Cosmo1233/CosFly/hardware/flight_controller_v1/Project Outputs for flight_controller_V1/BOM/flight_controller_BOM.xlsx

Description | Designator | Value | Footprint | Quantity | Manufacturer | Manufacturer Part # | Supplier 1 | Supplier Part #
RF ANTENNA Chip Solder Surface Mount ,2.4GHz ~ 2.5GHz ,2 W | ANT1 | 2450AT18B0100001E | ANTC3216X140N | 1 | JOHANSON TECHNOLOGY | 2450AT18B0100001E | Mouser | 609-2450AT18B0100001
Multilayer Ceramic Capacitors MLCC - SMD/SMT Hi-Q 0402 1.2pF 0.1 | C1 | 1.2pF | 0402 (1005 metric) CAP IPC-7351 Level B SMD | 1 | JOHANSON TECHNOLOGY | QSCF500Q1R2B1GV001T | Mouser | 609-QSCF500Q1R2B1GV0
Multilayer Ceramic Capacitors MLCC - SMD/SMT Hi-Q 0402 2.4pF 0.1 | C2 | 2.4pF | 0402 (1005 metric) CAP IPC-7351 Level B SMD | 1 | JOHANSON TECHNOLOGY | QSCF500Q2R4B1GV001T | Mouser | 609-QSCF500Q2R4B1GV0
Multilayer Ceramic Capacitors MLCC - SMD/SMT Hi-Q 0402 2.7pF 0.1 | C3 | 2.7pF | 0402 (1005 metric) CAP IPC-7351 Level B SMD | 1 | JOHANSON TECHNOLOGY | QSCF500Q2R7B1GV001T | Mouser | 609-QSCF500Q2R7B1GV0
Multilayer Ceramic Capacitors MLCC - SMD/SMT 0.1 uF 16 VDC 10% 0402 X7R AEC-Q200 | C4, C10, C11, C12, C13, C17, C18, C19, C21, C22, C23, C24, C25, C26, C27, C28, C30 | 100nF | 0402 (1005 metric) CAP IPC-7351 Level B SMD | 17 | Murata Electronics | GCM155R71C104KA55D | Mouser | 81-GCM155R71C104KA5D
Multilayer Ceramic Capacitors MLCC - SMD/SMT 1 uF 16 VDC 10% 0402 X5R | C5, C9, C14, C16, C20 | 1uF | 0402 (1005 metric) CAP IPC-7351 Level B SMD | 5 | Murata Electronics | GRM155R61C105KA12J | Mouser | 81-GRM155R61C105KA2J
Multilayer Ceramic Capacitors MLCC - SMD/SMT 50V 12pF C0G 0402 0. 25pF | C6, C7 | 12pF | 0402 (1005 metric) CAP IPC-7351 Level B SMD | 2 | KYOCERA AVX | 04025U120CAT2A | Mouser | 581-04025U120CAT2A
Multilayer Ceramic Capacitors MLCC - SMD/SMT 10 uF 10 VDC 20% 0402 X5R | C8, C31, C32 | 10uF | 0402 (1005 metric) CAP IPC-7351 Level B SMD | 3 | Murata Electronics | GRM155R61A106ME11J | Mouser | 81-GRM155R61A106ME1J
Multilayer Ceramic Capacitors MLCC - SMD/SMT 1000 pF 50 VDC 10% 0402 X7R | C15 | 1nF | 0402 (1005 metric) CAP IPC-7351 Level B SMD | 1 | Murata Electronics | GRM155R71H102KA01D | Mouser | 81-GRM36X102K50
Multilayer Ceramic Capacitors MLCC - SMD/SMT 0402 10VDC X5R 4.7uF Tol 10% AEC-Q200 | C29 | 4.7uF | 0402 (1005 metric) CAP IPC-7351 Level B SMD | 1 | TAIYO YUDEN | MSASL105BB5475KFNA01 | Mouser | 963-MSASL105BB5475KF
Multilayer Ceramic Capacitors MLCC - SMD/SMT 4.7UF 10V 10% 0603 | C33 | 4.7uF | 0603 (1608 metric) CAP IPC-7351 Level B SMD | 1 | TAIYO YUDEN | MSASL168SB5475KTNA01 | Mouser | 963-MSASL168SB5475KT
Multilayer Ceramic Capacitors MLCC - SMD/SMT 22 uF 10 VDC 20% 0603 X5R | C34 | 22uF | 0603 (1608 metric) CAP IPC-7351 Level B SMD | 1 | Murata Electronics | GRM188R61A226ME15D | Mouser | 81-GRM188R61A226ME5D
TVS Diode Array Uni-Directional USBLC6-2SC6 17V, SOT-23 6-Pin | D1 | USBLC6-2SC6 | USBLC6-2 SOT-666 | 1 | STMicroelectronics | USBLC6-2SC6 | Mouser | 511-USBLC6-2SC6
LED | D2, D9 | LTST-S326KGJRKT | LTST-S326KGJRKT | 2 | Lite-On | LTST-S326KGJRKT | Mouser | 859-LTST-S326KGJRKT
Standard LEDs - SMD Blue LED | D3, D10 | IN-S85CS5B | INS85CS5B | 2 | Inolux | IN-S85CS5B | Mouser | 743-IN-S85CS5B
Bottom ViewEM/CM/EMS Only | D4 | PESDNC2FD3V3BS | PESDNC2FD3V3BS | 1 | Prisemi | PESDNC2FD3V3BS | LCSC Electronics | C496536
Shottky Diode 20V 1A Surface Mount SOD-323 | D5, D6, D7, D8 | 1N5817WS | SOD2613X110N | 4 | Guangdong Hottech | 1N5817WS | LCSC Electronics | C5190152
USB-C (USB TYPE-C) Receptacle Connector 16 Position Surface Mount | J1 | TYPE-C-31-M-12 | USB-C-31-M-12 | 1 | HRO Electronics | TYPE-C-31-M-12 | LCSC Electronics | C165948
1.25mm Pitch, PicoBlade PCB Header, Single Row, Right-Angle, Surface Mount, Tin (Sn) Plating, Friction Lock, 2 Circuits, Natural, Tape and Reel | J5, J6, J7, J8 | 53048-0210 | 53048-0210 | 4 | Molex Connector Corporation | 53048-0210 | Mouser | 538-53048-0210
RF Inductors - SMD RF MLI 0402 3.3nH 0.3 | L1 | 3.3nH | 0402 (1005 metric) IND IPC-7351 Level B SMD_ | 1 | JOHANSON TECHNOLOGY | LRC0402CS3N3GV001T | Mouser | 609-LRC0402CS3N3GV00
RF Inductors - SMD RF MLI 0402 2.4nH 0.3 | L2 | 2.4nH | 0402 (1005 metric) IND IPC-7351 Level B SMD_ | 1 | JOHANSON TECHNOLOGY | LRC0402CS2N4GV001T | Mouser | 609-LRC0402CS2N4GV00
RF Inductors - SMD RF MLI 0402 2.7nH 0.3 | L3 | 2.7nH | 0402 (1005 metric) IND IPC-7351 Level B SMD_ | 1 | JOHANSON TECHNOLOGY | LRC0402CS2N7GV001T | Mouser | 609-LRC0402CS2N7GV00
RF Inductors - SMD IND 0402 2.0nH S-HQ SMD RF IND | L4 | 2nH | 0402 (1005 metric) IND IPC-7351 Level B SMD_ | 1 | TDK | MHQ1005P2N0CT000 | Mouser | 810-MHQ1005P2N0CT000
SI2302DDS-T1-GE3 N-Channel MOSFET, 2.6 A, 20 V, 3-Pin SOT-363 Vishay | Q1, Q2, Q3, Q4 | SI2302DDS-T1-GE3 | SOT95P237X112-3N | 4 | Vishay | SI2302DDS-T1-GE3 | Mouser | 78-SI2302DDS-T1-GE3
Thick Film Resistors - SMD 2.2K OHM 5% | R1, R2 | 2.2kΩ | 0402 (1005 metric) RES IPC-7351 Level B SMD | 2 | Bourns | CR0402-JW-222GLF | Mouser | 652-CR0402JW-222GLF
Thick Film Resistors - SMD 4.7K OHM 5% | R7, R8, R27, R28, R29 | 4.7kΩ | 0402 (1005 metric) RES IPC-7351 Level B SMD | 5 | Bourns | CR0402-JW-472GLF | Mouser | 652-CR0402-JW-472GLF
Thick Film Resistors - SMD 10K OHM 1% | R3, R14, R16, R17, R23, R24, R25, R26, R32, R34, R40 | 10kΩ | 0402 (1005 metric) RES IPC-7351 Level B SMD | 11 | Bourns | CR0402AFX-1002GAS | Mouser | 652-CR0402AFX1002GAS
Thick Film Resistors 5.1K OHM 1% | R4, R5 | 5.1kΩ | 0402 (1005 metric) RES IPC-7351 Level B SMD | 2 | Bourns | CR0402-FX-5101GLF | Mouser | 652-CR0402FX-5101GLF
Thick Film Resistors - SMD 22 Ohms 1/16 W 50 V 1% 0402 100 PPM / C - 55 C + 155 C AEC-Q200 | R6 | 22Ω | 0402 (1005 metric) RES IPC-7351 Level B SMD | 1 | Yageo | AC0402FR-0722RL | Mouser | 603-AC0402FR-0722RL
Thin Film Resistors - SMD 1/16W 620 ohm .1% 25ppm | R9, R37 | 620Ω | 0402 (1005 metric) RES IPC-7351 Level B SMD | 2 | Yageo | RT0402BRD07620RL | Mouser | 603-RT0402BRD07620RL
Thick Film Resistors - SMD 270 Ohms 1/16 W 50 V 1% 0402 100 PPM / C - 55 C + 155 C AEC-Q200 | R10, R11, R38, R39 | 270Ω | 0402 (1005 metric) RES IPC-7351 Level B SMD | 4 | Yageo | AC0402FR-07270RL | Mouser | 603-AC0402FR-07270RL
Thin Film Resistors - SMD 100K Ohm 0.1% 1/16W 50 Volts 50ppm | R12, R18, R30, R36 | 100kΩ | 0402 (1005 metric) RES IPC-7351 Level B SMD | 4 | Yageo | RT0402BRE07100KL | Mouser | 603-RT0402BRE07100KL
Thick Film Resistors - SMD 510 OHM 1% | R13 | 510Ω | 0402 (1005 metric) RES IPC-7351 Level B SMD | 1 | Bourns | CR0402-FX-5100GLF | Mouser | 652-CR0402FX-5100GLF
Thick Film Resistors - SMD 200K OHM 1% | R15 | 200kΩ | 0402 (1005 metric) RES IPC-7351 Level B SMD | 1 | Bourns | CR0402-FX-2003GLF | Mouser | 652-CR0402FX-2003GLF
Thick Film Resistors - SMD 47 Ohms 1/8 W 100 V 5 % 0402 100 PPM / C - 55 C / + 155 C AEC-Q200 | R19, R20, R21, R22 | 47Ω | 0402 (1005 metric) RES IPC-7351 Level B SMD | 4 | Yageo | AC0402JR-7W47RL | Mouser | 603-AC0402JR-7W47RL
Thin Film Resistors - SMD 1K ohm 1% 1/16W | R31, R33 | 1kΩ | 0402 (1005 metric) RES IPC-7351 Level B SMD | 2 | Yageo | RT0402FRE071KL | Mouser | 603-RT0402FRE071KL
Thin Film Resistors - SMD 1/16W 22.1K ohm 1% 50ppm | R35 | 22.1kΩ | 0402 (1005 metric) RES IPC-7351 Level B SMD | 1 | Yageo | RT0402FRE0722K1L | Mouser | 603-RT0402FRE0722K1L
Tactile Switches Top Actuated w/o boss w/o ground | S1, S2 | B3U-1000P | B3U-1000P | 2 | OMRON Electronics | B3U-1000P | Mouser | 653-B3U-1000P
Toggle Switches 5*2.75mm RoHS | S3 | K3-1292M | K3-1292M | 1 | Korean Hroparts Elec | K3-1292M
Single-Pole, Double-Throw Analog Switch | S4 | SN74LVC1G3157DRLR | SOTFL50P160X60-6N | 1 | Texas Instruments | SN74LVC1G3157DRLR | Mouser | 595-SN74LVC1G3157DRL
Espressif Systems [ENGINEERING SAMPLES]SMD IC , Dual-Core MCU, Wi-Fi 2.4G & BLE 5.0 combo, 8 MB Octal SPI PSRAM | U1 | ESP32-S3FN8 | ESP32-S3FN8 | 1 | Espressif Systems | ESP32-S3FN8 | Mouser | 356-ESP32-S3FN8
Power Switch ICs - Power Distribution 1A Slew Rate Ctrl Load Switch | U2 | SIP32431DNP3-T1GE4 | SON50P160X120X60-5N-D | 1 | Vishay | SIP32431DNP3-T1GE4 | Mouser | 781-SIP32431DNP3-GE4
Remote 8-Bit I2C and Low-Power I/O Expander With Interrupt Output and Configuration Registers | U3 | PCA9534ARGTR | QFN50P300X300X100-17N-D | 1 | Texas Instruments | PCA9534ARGTR | Mouser | 595-PCA9534ARGTR
EEPROM 64K 8KX8 1.8V SER EE IND 1/4AWP RPO | U4 | 24AA64FT-I_MNY | SON50P300X200X80-9N-D | 1 | Microchip | 24AA64FT-I/MNY | Mouser | 579-24AA64FT-I/MNY
IMUs - Inertial Measurement Units Smart Ultra-Low Power Inertial Measurement Unit (IMU) for Wearable Applications | U5 | BMI270 | BMI270 | 1 | BOSCH | BMI270 | LCSC Electronics | C2836813
Board Mount Hall Effect / Magnetic Sensors 3-Axis 1.56x1.56mm WLCSP-12 Geomagnetic | U6 | BMM150 | BMM150 | 1 | BOSCH | BMM150 | LCSC Electronics | C171681
IC; SNSR; DIGITAL; BAROMETRIC PRESSURE SENSOR; LGA8 | U7 | BMP280 | BMP280 | 1 | Bosch Sensortec | BMP280 | LCSC Electronics | C83291
Automotive 4.35V to 16V, 1.5A Li-Ion Charger with Power-Path Management for 5.5V Systems | U8 | BQ24075QRGTRQ1 | QFN50P300X300X100-17N-D | 1 | Texas Instruments | BQ24075QRGTRQ1 | Mouser | 595-BQ24075QRGTRQ1
DC/DC Converters - SMD 1A 5Vin inductor-integrated DC-DC converter | U9 | MUN3CAD01-SC | MUN3CAD01SC | 1 | Cyntec | MUN3CAD01-SC | Mouser | 108-MUN3CAD01-SC
40 MHz +/-10ppm Crystal 10pF 40 Ohms 4-SMD, No Lead , -20C ~ 70C | X1 | 40MHz | ECS4001037B2CKMTR | 1 | ECS | ECS-400-10-37B2-CKM-TR | Mouser | 520-400-10-37B2CKMTR
