Cosmo1233/CosFly/hardware/flight_controller_v1/flight_controller.step

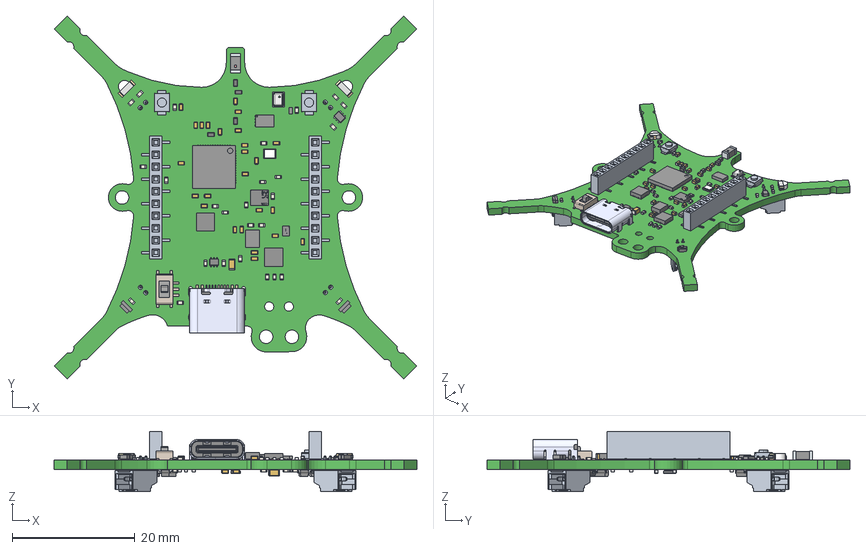
[picture p1: CAD file, 2026-10-15]
hardware/flight_controller_v1/flight_controller.step
59.2 x 59.2 x 9.86 mm
Extruded x 120
BMM150
BODY-SOT
PIN1-ID x 3
Pins x 4
HRO_K3-1293S - K3-1292M
BODY-QFN x 2
B3U-1000P x 2
ThermalPin x 2
PinsArrayLR x 2
PinsArrayTB
TYPE-C-31-M-12
ECS-400-10-37B2-CKM-TR
BMI270
pins
part number
PinsArrayL x 4
FilletPinR x 8
FilletPinL x 4
term1
term2
