Cosmo1233/CosFly/Documents/Schematics/flight_controller_main.pdf

## Breakout & Battery Connectors USB-C Power / Data Connector

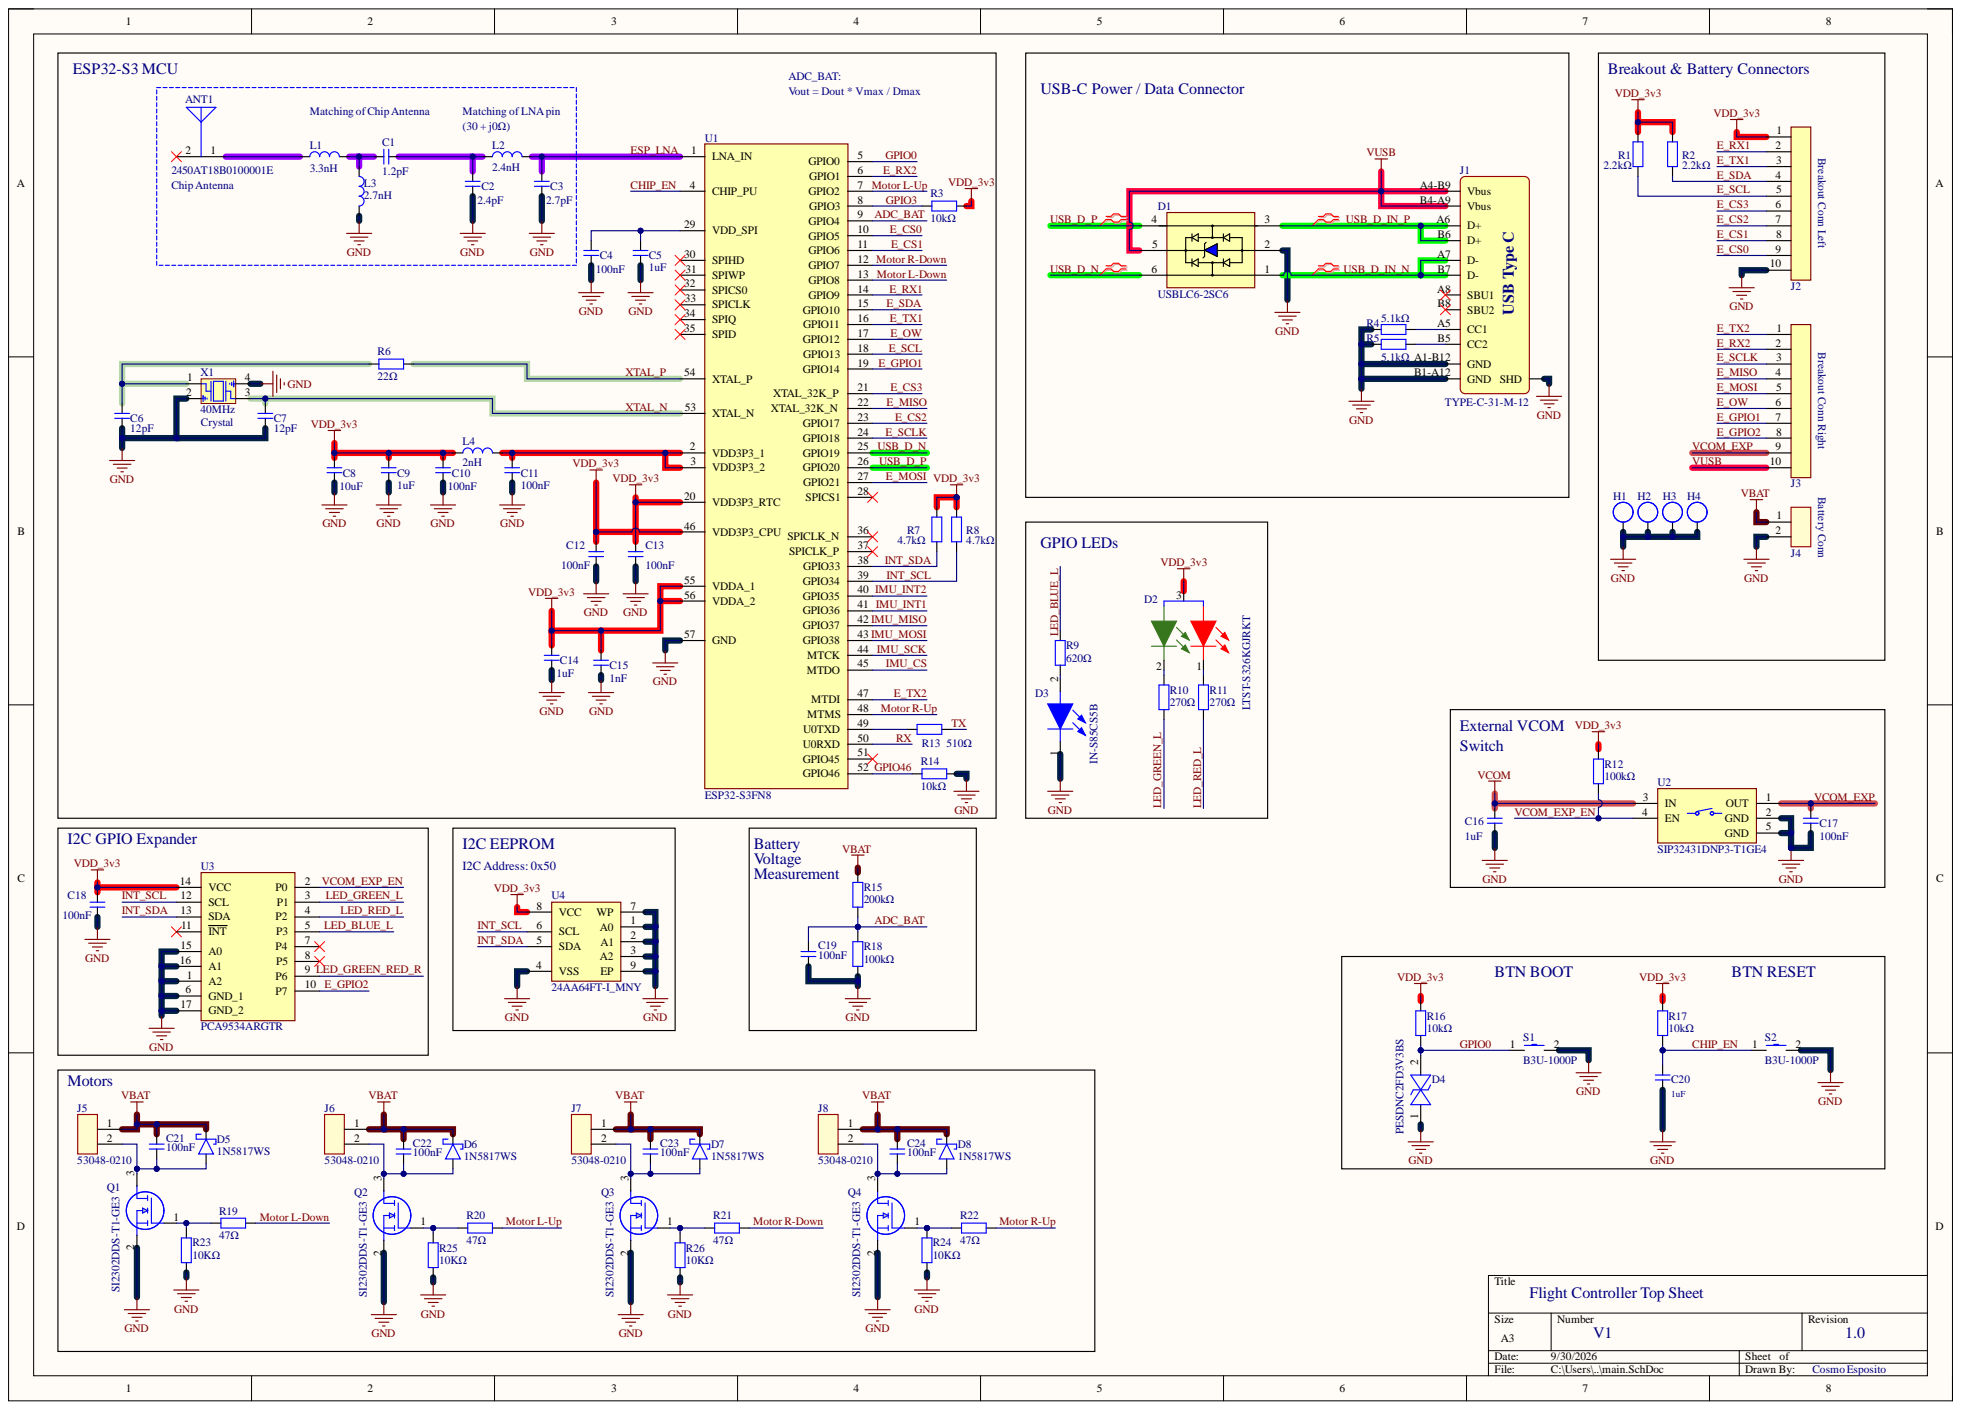
[picture p2: page 1]

ADC_BAT:
Vout = Dout * Vmax / Dmax

Breakout Conn Left Breakout Conn Right

Title
Flight Controller Top Sheet
