Cosmo1233/CosFly/Documents/Schematics/flight_controller_pm.pdf

## PMIC

## & 3.3V Buck Converter

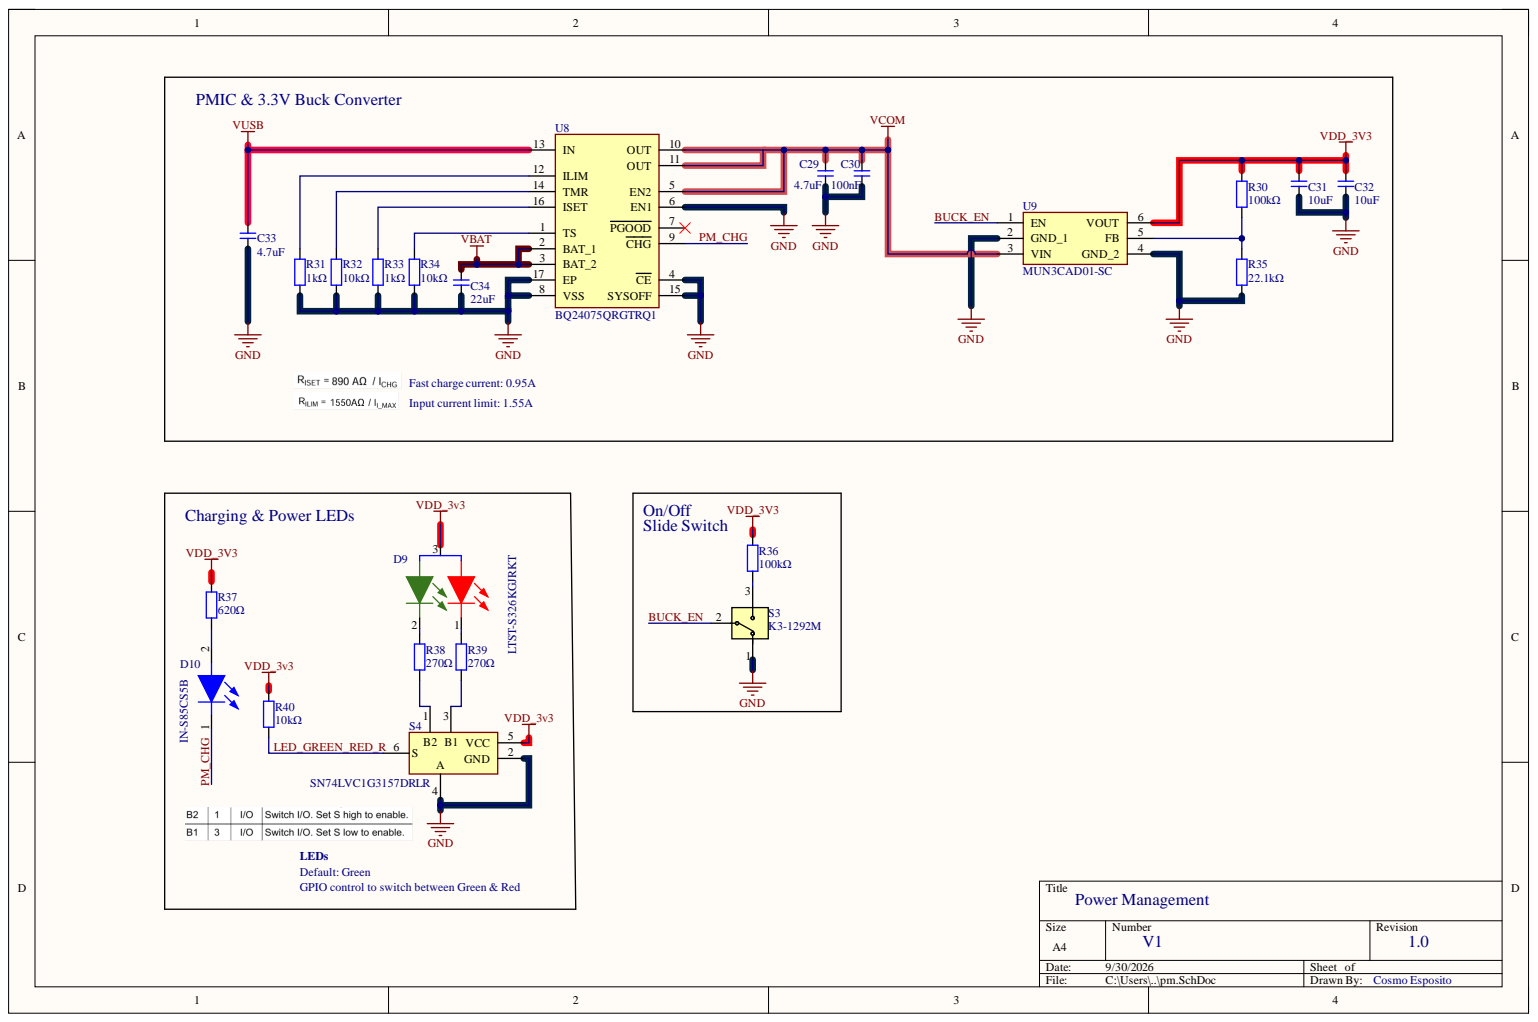
[picture p3: page 1]
Size; umb; Rev; Dat; Sheet; sers; pm.Sch; Draw; Power Management V1; smo; BAT_; VSS; ILIM; ISE; SYSOFF; TMR; QRG; VBAT; VCO; BUCK; CHG 1 2; LTST-S326KGJRKT; VCC; LVC1; RLR; Charging; & Power LED; ide Sw; tch; t curren; imi; Fas; t charge curren; GRE; Defau; Green; GPIO co; tro; bet; ween; Green & Red; LED
