Cosmo1233/CosFly/Documents/Schematics/flight_controller_sensors.pdf

IMU | Magnetometer

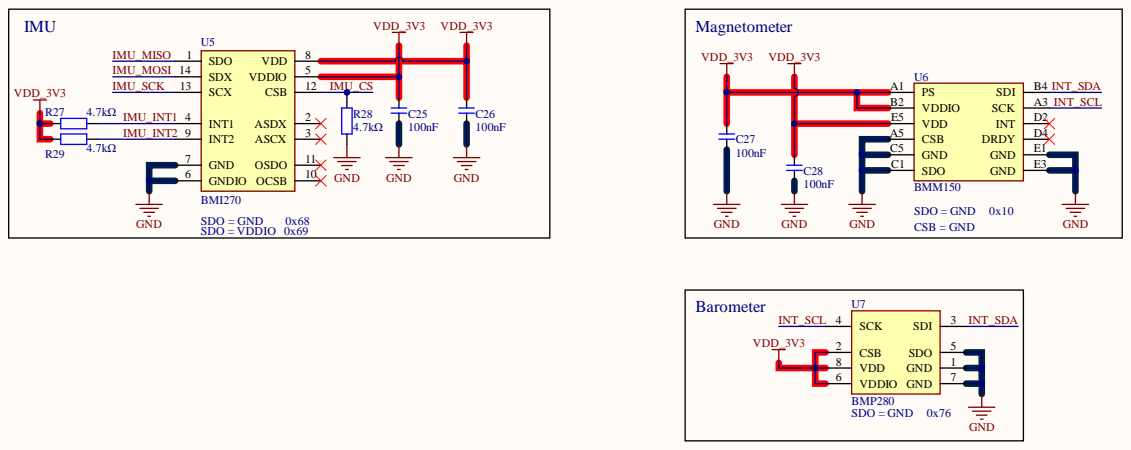
[picture p4: page 1]
