Cosmo1233/CosFly/hardware/flight_controller_v1/Sch PDFs/flight_controller_V1.pdf

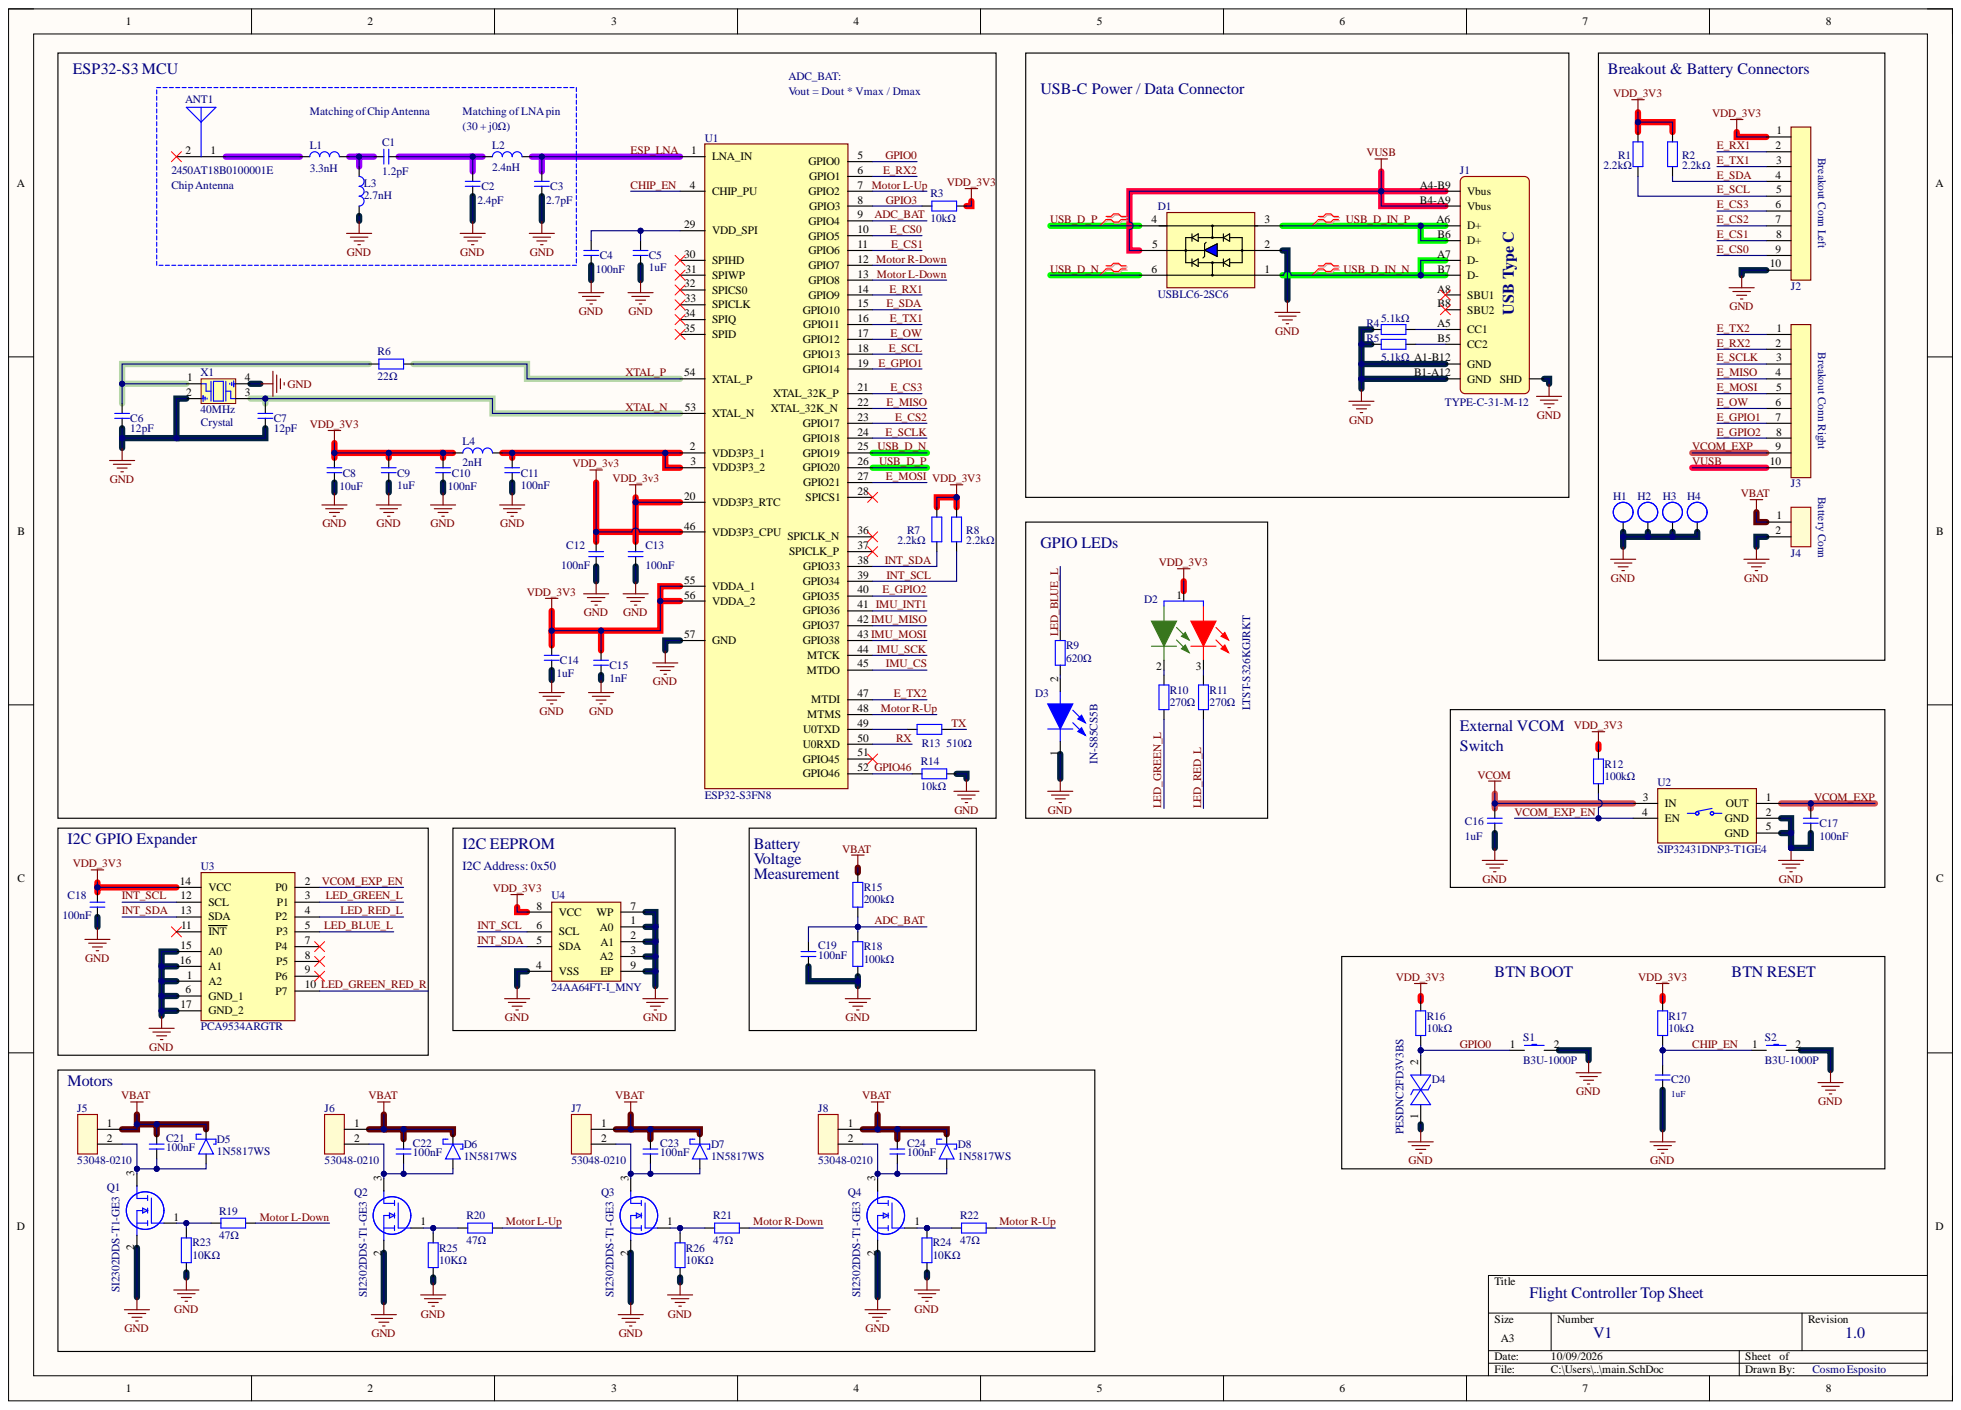
[picture p5: page 1]

ADC_BAT:
Vout = Dout * Vmax / Dmax

USB-C Power / Data Connector

Breakout Conn Left Breakout Conn Right

Title
Flight Controller Top Sheet

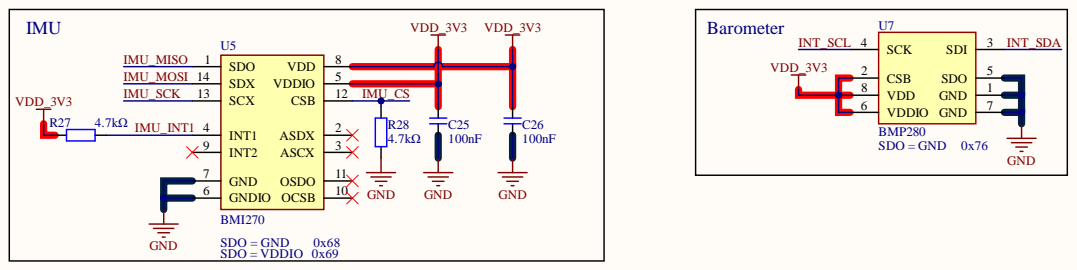
[picture p6: page 2]

IMU _ C S

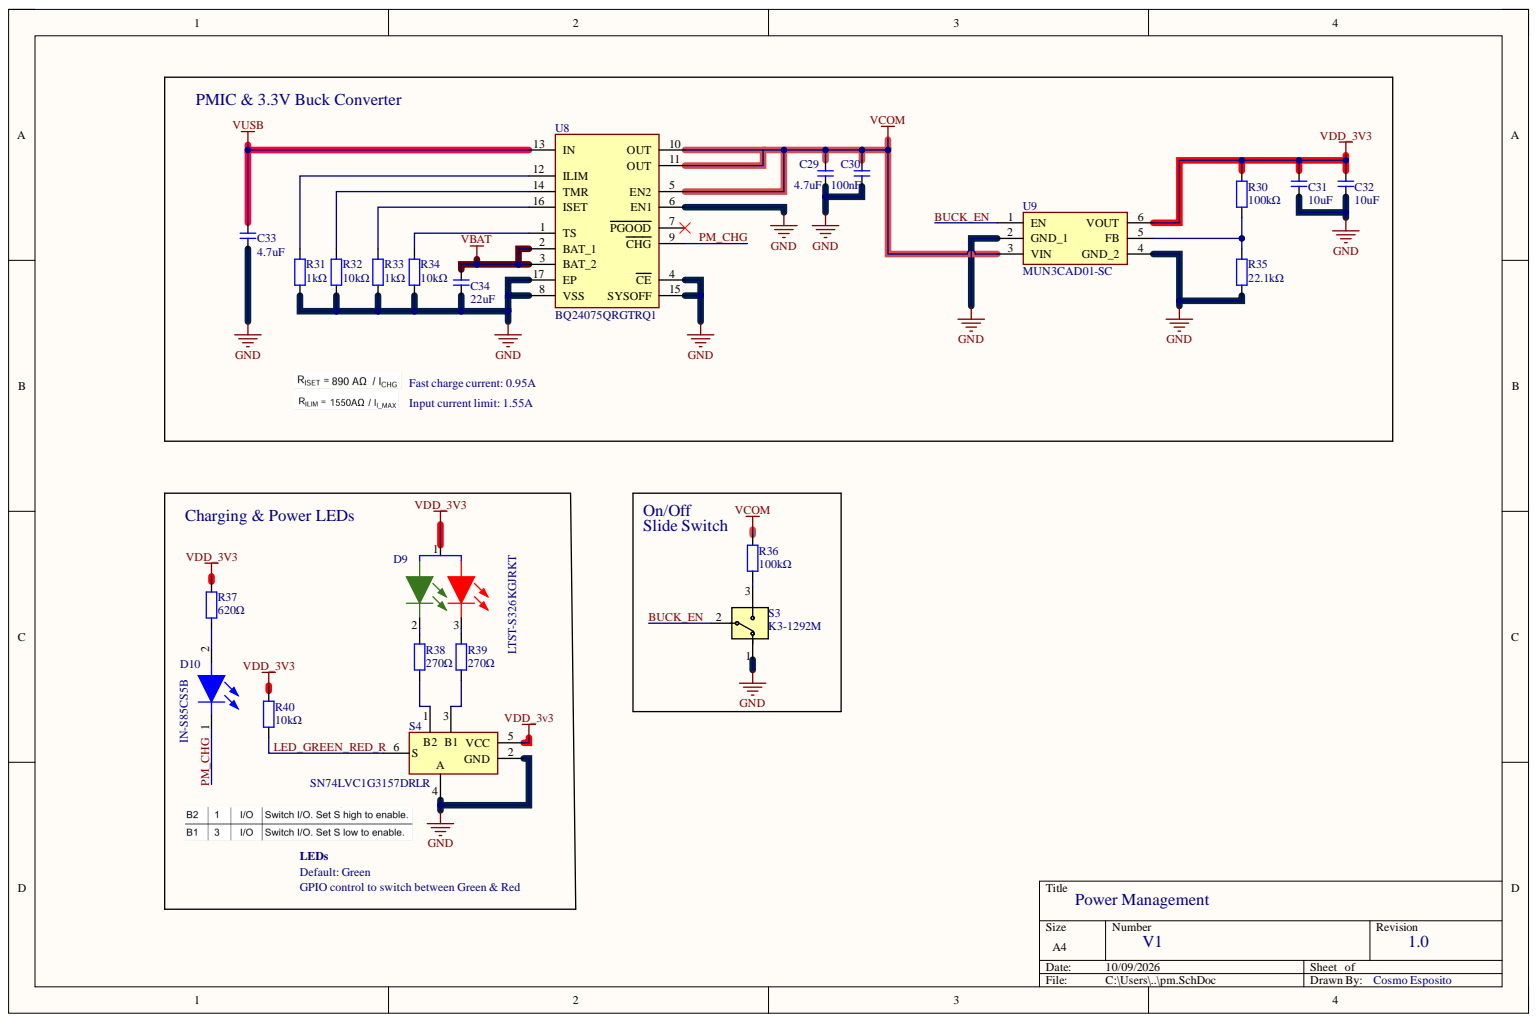
[picture p7: page 3]

1 4
1 6 | 6
