Cosmo1233/CosFly/(list of files, drawings)

Other design files:
hardware/flight_controller_v1/flight_controller.PcbDoc
hardware/flight_controller_v1/flight_controller_footprint_lib.PcbLib
hardware/flight_controller_v1/flight_controller_schematic_lib.SchLib
hardware/flight_controller_v1/flight_controller_V1.PrjPcb
hardware/flight_controller_v1/main.SchDoc
hardware/flight_controller_v1/pm.SchDoc
hardware/flight_controller_v1/sensors.SchDoc
