Cosmo1233/CosFly/components/drivers/i2c_devices/bmp280/driver_bmp280.c

/**
 * Copyright (c) 2015 - present LibDriver All rights reserved
 *
 * The MIT License (MIT)
 *
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
 * @file      driver_bmp280.c
 * @brief     driver bmp280 source file
 * @version   1.0.0
 * @author    Shifeng Li
 * @date      2024-01-15
 *
 * <h3>history</h3>
 * <table>
 * <tr><th>Date        <th>Version  <th>Author      <th>Description
 * <tr><td>2024/01/15  <td>1.0      <td>Shifeng Li  <td>first upload
 * </table>
 */

#include "driver_bmp280.h"

/**
 * @brief chip information definition
 */
#define CHIP_NAME                 "Bosch BMP280"        /**< chip name */
#define MANUFACTURER_NAME         "Bosch"               /**< manufacturer name */
#define SUPPLY_VOLTAGE_MIN        1.71f                 /**< chip min supply voltage */
#define SUPPLY_VOLTAGE_MAX        3.6f                  /**< chip max supply voltage */
#define MAX_CURRENT               1.12f                 /**< chip max current */
#define TEMPERATURE_MIN           -40.0f                /**< chip min operating temperature */
#define TEMPERATURE_MAX           85.0f                 /**< chip max operating temperature */
#define DRIVER_VERSION            1000                  /**< driver version */

/**
 * @brief chip register definition
 */
#define BMP280_REG_NVM_PAR_T1_L        0x88        /**< NVM PAR T1 low register */
#define BMP280_REG_NVM_PAR_T1_H        0x89        /**< NVM PAR T1 high register */
#define BMP280_REG_NVM_PAR_T2_L        0x8A        /**< NVM PAR T2 low register */
#define BMP280_REG_NVM_PAR_T2_H        0x8B        /**< NVM PAR T2 high register */
#define BMP280_REG_NVM_PAR_T3_L        0x8C        /**< NVM PAR T3 low register */
#define BMP280_REG_NVM_PAR_T3_H        0x8D        /**< NVM PAR T3 high register */
#define BMP280_REG_NVM_PAR_P1_L        0x8E        /**< NVM PAR P1 low register */
#define BMP280_REG_NVM_PAR_P1_H        0x8F        /**< NVM PAR P1 high register */
#define BMP280_REG_NVM_PAR_P2_L        0x90        /**< NVM PAR P2 low register */
#define BMP280_REG_NVM_PAR_P2_H        0x91        /**< NVM PAR P2 high register */
#define BMP280_REG_NVM_PAR_P3_L        0x92        /**< NVM PAR P3 low register */
#define BMP280_REG_NVM_PAR_P3_H        0x93        /**< NVM PAR P3 high register */
#define BMP280_REG_NVM_PAR_P4_L        0x94        /**< NVM PAR P4 low register */
#define BMP280_REG_NVM_PAR_P4_H        0x95        /**< NVM PAR P4 high register */
#define BMP280_REG_NVM_PAR_P5_L        0x96        /**< NVM PAR P5 low register */
#define BMP280_REG_NVM_PAR_P5_H        0x97        /**< NVM PAR P5 high register */
#define BMP280_REG_NVM_PAR_P6_L        0x98        /**< NVM PAR P6 low register */
#define BMP280_REG_NVM_PAR_P6_H        0x99        /**< NVM PAR P6 high register */
#define BMP280_REG_NVM_PAR_P7_L        0x9A        /**< NVM PAR P7 low register */
#define BMP280_REG_NVM_PAR_P7_H        0x9B        /**< NVM PAR P7 high register */
#define BMP280_REG_NVM_PAR_P8_L        0x9C        /**< NVM PAR P8 low register */
#define BMP280_REG_NVM_PAR_P8_H        0x9D        /**< NVM PAR P8 high register */
#define BMP280_REG_NVM_PAR_P9_L        0x9E        /**< NVM PAR P9 low register */
#define BMP280_REG_NVM_PAR_P9_H        0x9F        /**< NVM PAR P9 high register */
#define BMP280_REG_TEMP_XLSB           0xFC        /**< temp xlsb register */
#define BMP280_REG_TEMP_LSB            0xFB        /**< temp lsb register */
#define BMP280_REG_TEMP_MSB            0xFA        /**< temp msb register */
#define BMP280_REG_PRESS_XLSB          0xF9        /**< press xlsb register */
#define BMP280_REG_PRESS_LSB           0xF8        /**< press lsb register */
#define BMP280_REG_PRESS_MSB           0xF7        /**< press msb register */
#define BMP280_REG_CONFIG              0xF5        /**< config register */
#define BMP280_REG_CTRL_MEAS           0xF4        /**< ctrl meas register */
#define BMP280_REG_STATUS              0xF3        /**< status register */
#define BMP280_REG_RESET               0xE0        /**< soft reset register */
#define BMP280_REG_ID                  0xD0        /**< chip id register */

/**
 * @brief      read multiple bytes
 * @param[in]  *handle pointer to a bmp280 handle structure
 * @param[in]  reg register address
 * @param[out] *buf pointer to a data buffer
 * @param[in]  len data length
 * @return     status code
 *             - 0 success
 *             - 1 iic spi read failed
 * @note       none
 */
static uint8_t a_bmp280_iic_spi_read(bmp280_handle_t *handle, uint8_t reg, uint8_t *buf, uint16_t len)
{
    if (handle->iic_spi == BMP280_INTERFACE_IIC)                           /* iic interface */
    {
        if (handle->iic_read(handle->iic_addr, reg, buf, len) != 0)        /* iic read */
        {
            return 1;                                                      /* return error */
        }

        return 0;                                                          /* success return 0 */
    }
    else                                                                   /* spi interface */
    {
        reg |= 1 << 7;                                                     /* set read mode */
        if (handle->spi_read(reg, buf, len) != 0)                          /* spi read */
        {
            return 1;                                                      /* return error */
        }

        return 0;                                                          /* success return 0 */
    }
}

/**
 * @brief     write multiple bytes
 * @param[in] *handle pointer to a bmp280 handle structure
 * @param[in] reg register address
 * @param[in] *buf pointer to a data buffer
 * @param[in] len data length
 * @return    status code
 *            - 0 success
 *            - 1 iic spi write failed
 * @note      none
 */
static uint8_t a_bmp280_iic_spi_write(bmp280_handle_t *handle, uint8_t reg, uint8_t *buf, uint16_t len)
{
    if (handle->iic_spi == BMP280_INTERFACE_IIC)                           /* iic interface */
    {
        if (handle->iic_write(handle->iic_addr, reg, buf, len) != 0)       /* iic write */
        {
            return 1;                                                      /* return error */
        }

        return 0;                                                          /* success return 0 */
    }
    else                                                                   /* spi interface */
    {
        reg &= ~(1 << 7);                                                  /* write mode */
        if (handle->spi_write(reg, buf, len) != 0)                         /* spi write */
        {
            return 1;                                                      /* return error */
        }

        return 0;                                                          /* success return 0 */
    }
}

/**
 * @brief     get nvm calibration
 * @param[in] *handle pointer to a bmp280 handle structure
 * @return    status code
 *            - 0 success
 *            - 1 get calibration data failed
 * @note      none
 */
static uint8_t a_bmp280_get_nvm_calibration(bmp280_handle_t *handle)
{
    uint8_t buf[2];

    if (a_bmp280_iic_spi_read(handle, BMP280_REG_NVM_PAR_T1_L, (uint8_t *)buf, 2) != 0)        /* read t1 */
    {
        handle->debug_print("bmp280: get calibration data failed.\n");                         /* get calibration data failed */

        return 1;                                                                              /* return error */
    }
    handle->t1 = (uint16_t)buf[1] << 8 | buf[0];                                               /* set t1 */
    if (a_bmp280_iic_spi_read(handle, BMP280_REG_NVM_PAR_T2_L, (uint8_t *)buf, 2) != 0)        /* read t2 */
    {
        handle->debug_print("bmp280: get calibration data failed.\n");                         /* get calibration data failed */

        return 1;                                                                              /* return error */
    }
    handle->t2 = (int16_t)((uint16_t)buf[1] << 8 | buf[0]);                                    /* set t2 */
    if (a_bmp280_iic_spi_read(handle, BMP280_REG_NVM_PAR_T3_L, (uint8_t *)buf, 2) != 0)        /* read t3 */
    {
        handle->debug_print("bmp280: get calibration data failed.\n");                         /* get calibration data failed */

        return 1;                                                                              /* return error */
    }
    handle->t3 = (int16_t)((uint16_t)buf[1] << 8 | buf[0]);                                    /* set t3 */
    if (a_bmp280_iic_spi_read(handle, BMP280_REG_NVM_PAR_P1_L, (uint8_t *)buf, 2) != 0)        /* read p1 */
    {
        handle->debug_print("bmp280: get calibration data failed.\n");                         /* get calibration data failed */

        return 1;                                                                              /* return error */
    }
    handle->p1 = (uint16_t)buf[1] << 8 | buf[0];                                               /* set p1 */
    if (a_bmp280_iic_spi_read(handle, BMP280_REG_NVM_PAR_P2_L, (uint8_t *)buf, 2) != 0)        /* read p2 */
    {
        handle->debug_print("bmp280: get calibration data failed.\n");                         /* get calibration data failed */

        return 1;                                                                              /* return error */
    }
    handle->p2 = (int16_t)((uint16_t)buf[1] << 8 | buf[0]);                                    /* set p2 */
    if (a_bmp280_iic_spi_read(handle, BMP280_REG_NVM_PAR_P3_L, (uint8_t *)buf, 2) != 0)        /* read p3 */
    {
        handle->debug_print("bmp280: get calibration data failed.\n");                         /* get calibration data failed */

        return 1;                                                                              /* return error */
    }
    handle->p3 = (int16_t)((uint16_t)buf[1] << 8 | buf[0]);                                    /* set p3 */
    if (a_bmp280_iic_spi_read(handle, BMP280_REG_NVM_PAR_P4_L, (uint8_t *)buf, 2) != 0)        /* read p4 */
    {
        handle->debug_print("bmp280: get calibration data failed.\n");                         /* get calibration data failed */

        return 1;                                                                              /* return error */
    }
    handle->p4 = (int16_t)((uint16_t)buf[1] << 8 | buf[0]);                                    /* set p4 */
    if (a_bmp280_iic_spi_read(handle, BMP280_REG_NVM_PAR_P5_L, (uint8_t *)buf, 2) != 0)        /* read p5 */
    {
        handle->debug_print("bmp280: get calibration data failed.\n");                         /* get calibration data failed */

        return 1;                                                                              /* return error */
    }
    handle->p5 = (int16_t)((uint16_t)buf[1] << 8 | buf[0]);                                    /* set p5 */
    if (a_bmp280_iic_spi_read(handle, BMP280_REG_NVM_PAR_P6_L, (uint8_t *)buf, 2) != 0)        /* read p6 */
    {
        handle->debug_print("bmp280: get calibration data failed.\n");                         /* get calibration data failed */

        return 1;                                                                              /* return error */
    }
    handle->p6 = (int16_t)((uint16_t)buf[1] << 8 | buf[0]);                                    /* set p6 */
    if (a_bmp280_iic_spi_read(handle, BMP280_REG_NVM_PAR_P7_L, (uint8_t *)buf, 2) != 0)        /* read p7 */
    {
        handle->debug_print("bmp280: get calibration data failed.\n");                         /* get calibration data failed */

        return 1;                                                                              /* return error */
    }
    handle->p7 = (int16_t)((uint16_t)buf[1] << 8 | buf[0]);                                    /* set p7 */
    if (a_bmp280_iic_spi_read(handle, BMP280_REG_NVM_PAR_P8_L, (uint8_t *)buf, 2) != 0)        /* read p8 */
    {
        handle->debug_print("bmp280: get calibration data failed.\n");                         /* get calibration data failed */

        return 1;                                                                              /* return error */
    }
    handle->p8 = (int16_t)((uint16_t)buf[1] << 8 | buf[0]);                                    /* set p8 */
    if (a_bmp280_iic_spi_read(handle, BMP280_REG_NVM_PAR_P9_L, (uint8_t *)buf, 2) != 0)        /* read p9 */
    {
        handle->debug_print("bmp280: get calibration data failed.\n");                         /* get calibration data failed */

        return 1;                                                                              /* return error */
    }
    handle->p9 = (int16_t)((uint16_t)buf[1] << 8 | buf[0]);                                    /* set p9 */
    handle->t_fine = 0;                                                                        /* init 0 */

    return 0;                                                                                  /* success return 0 */
}

/**
 * @brief      compensate temperature
 * @param[in]  *handle pointer to a bmp280 handle structure
 * @param[in]  raw raw data
 * @param[out] *output pointer to an output buffer
 * @return     status code
 *             - 0 success
 *             - 1 compensate temperature failed
 * @note       none
 */
static uint8_t a_bmp280_compensate_temperature(bmp280_handle_t *handle, uint32_t raw, float *output)
{
    uint8_t res;
    float var1;
    float var2;
    float temperature;

    var1 = (((float)raw) / 16384.0f - ((float)handle->t1) / 1024.0f) * ((float)handle->t2);        /* set var1 */
    var2 = ((((float)raw) / 131072.0f - ((float)handle->t1) / 8192.0f) *
           (((float)raw) / 131072.0f - ((float)handle->t1) / 8192.0f)) *
           ((float)handle->t3);                                                                    /* set var2 */
    handle->t_fine = (int32_t)(var1 + var2);                                                       /* set t_fine */
    temperature = (var1 + var2) / 5120.0f;                                                         /* set temperature */
    res = 0;                                                                                       /* init 0 */
    if (temperature < -40.0f)                                                                      /* check temperature min */
    {
        temperature = -40.0f;                                                                      /* set min */
        res = 1;                                                                                   /* set failed */
    }
    if (temperature > 85.0f)                                                                       /* check temperature max */
    {
        temperature = 85.0f;                                                                       /* set max */
        res = 1;                                                                                   /* set failed */
    }
    (*output) = temperature;                                                                       /* set output temperature */

    return res;                                                                                    /* return result */
}

/**
 * @brief      compensate pressure
 * @param[in]  *handle pointer to a bmp280 handle structure
 * @param[in]  raw raw data
 * @param[out] *output pointer to an output buffer
 * @return     status code
 *             - 0 success
 *             - 1 compensate pressure failed
 * @note       none
 */
static uint8_t a_bmp280_compensate_pressure(bmp280_handle_t *handle, uint32_t raw, float *output)
{
    uint8_t res;
    float var1;
    float var2;
    float pressure;

    var1 = ((float)handle->t_fine / 2.0f) - 64000.0f;                             /* set var1 */
    var2 = var1 * var1 * ((float)handle->p6) / 32768.0f;                          /* set var2 */
    var2 = var2 + var1 * ((float)handle->p5) * 2.0f;                              /* set var2 */
    var2 = (var2 / 4.0f) + (((float)handle->p4) * 65536.0f);                      /* set var2 */
    var1 = (((float)handle->p3) * var1 * var1 / 524288.0f +
           ((float)handle->p2) * var1) / 524288.0f;                               /* set var1 */
    var1 = (1.0f + var1 / 32768.0f) * ((float)handle->p1);                        /* set var1 */
    pressure = 0.0f;                                                              /* init 0 */
    if (var1 < 0.0f || var1 > 0.0f)                                               /* check not zero */
    {
        pressure = 1048576.0f - (float)raw;                                       /* set pressure */
        pressure = (pressure - (var2 / 4096.0f)) * 6250.0f / var1;                /* set pressure */
        var1 = ((float)handle->p9) * pressure * pressure / 2147483648.0f;         /* set var1 */
        var2 = pressure * ((float)handle->p8) / 32768.0f;                         /* set var2 */
        pressure = pressure + (var1 + var2 + ((float)handle->p7)) / 16.0f;        /* set pressure */
        res = 0;                                                                  /* init 0 */
        if (pressure < 30000.0f)                                                  /* check pressure min */
        {
            pressure = 30000.0f;                                                  /* set pressure min */
            res = 1;                                                              /* set failed */
        }
        if (pressure > 110000.0f)                                                 /* check pressure max */
        {
            pressure = 110000.0f;                                                 /* set pressure max */
            res = 1;                                                              /* set failed */
        }

        (*output) = pressure;                                                     /* set pressure output */

        return res;                                                               /* return result */
    }
    else
    {
        res = 1;                                                                  /* set failed */
        (*output) = pressure;                                                     /* set pressure output */

        return res;                                                               /* return result */
    }
}

/**
 * @brief     set the iic address pin
 * @param[in] *handle pointer to a bmp280 handle structure
 * @param[in] addr_pin iic address pin
 * @return    status code
 *            - 0 success
 *            - 2 handle is NULL
 * @note      none
 */
uint8_t bmp280_set_addr_pin(bmp280_handle_t *handle, bmp280_address_t addr_pin)
{
    if (handle == NULL)                          /* check handle */
    {
        return 2;                                /* return error */
    }

    handle->iic_addr = (uint8_t)addr_pin;        /* set iic address */

    return 0;                                    /* success return 0 */
}

/**
 * @brief      get the iic address pin
 * @param[in]  *handle pointer to a bmp280 handle structure
 * @param[out] *addr_pin pointer to an iic address pin buffer
 * @return     status code
 *             - 0 success
 *             - 2 handle is NULL
 * @note       none
 */
uint8_t bmp280_get_addr_pin(bmp280_handle_t *handle, bmp280_address_t *addr_pin)
{
    if (handle == NULL)                                    /* check handle */
    {
        return 2;                                          /* return error */
    }

    *addr_pin = (bmp280_address_t)handle->iic_addr;        /* get iic address */

    return 0;                                              /* success return 0 */
}

/**
 * @brief     set the interface
 * @param[in] *handle pointer to a bmp280 handle structure
 * @param[in] interface chip interface
 * @return    status code
 *            - 0 success
 *            - 2 handle is NULL
 * @note      none
 */
uint8_t bmp280_set_interface(bmp280_handle_t *handle, bmp280_interface_t interface)
{
    if (handle == NULL)                        /* check handle */
    {
        return 2;                              /* return error */
    }

    handle->iic_spi = (uint8_t)interface;      /* set interface */

    return 0;                                  /* success return 0 */
}

/**
 * @brief      get the interface
 * @param[in]  *handle pointer to a bmp280 handle structure
 * @param[out] *interface pointer to a chip interface buffer
 * @return     status code
 *             - 0 success
 *             - 2 handle is NULL
 * @note       none
 */
uint8_t bmp280_get_interface(bmp280_handle_t *handle, bmp280_interface_t *interface)
{
    if (handle == NULL)                                        /* check handle */
    {
        return 2;                                              /* return error */
    }

    *interface = (bmp280_interface_t)(handle->iic_spi);        /* get interface */

    return 0;                                                  /* success return 0 */
}

/**
 * @brief     initialize the chip
 * @param[in] *handle pointer to a bmp280 handle structure
 * @return    status code
 *            - 0 success
 *            - 1 iic or spi initialization failed
 *            - 2 handle is NULL
 *            - 3 linked functions is NULL
 *            - 4 id is error
 *            - 5 get nvm calibration failed
 *            - 6 read calibration failed
 * @note      none
 */
uint8_t bmp280_init(bmp280_handle_t *handle)
{
    uint8_t id;
    uint8_t reg;

    if (handle == NULL)                                                              /* check handle */
    {
        return 2;                                                                    /* return error */
    }
    if (handle->debug_print == NULL)                                                 /* check debug_print */
    {
        return 3;                                                                    /* return error */
    }
    if (handle->iic_init == NULL)                                                    /* check iic_init */
    {
        handle->debug_print("bmp280: iic_init is null.\n");                          /* iic_init is nul */

        return 3;                                                                    /* return error */
    }
    if (handle->iic_deinit == NULL)                                                  /* check iic_deinit */
    {
        handle->debug_print("bmp280: iic_deinit is null.\n");                        /* iic_deinit is null */

        return 3;                                                                    /* return error */
    }
    if (handle->iic_read == NULL)                                                    /* check iic_read */
    {
        handle->debug_print("bmp280: iic_read is null.\n");                          /* iic_read is null */

        return 3;                                                                    /* return error */
    }
    if (handle->iic_write == NULL)                                                   /* check iic_write */
    {
        handle->debug_print("bmp280: iic_write is null.\n");                         /* iic_write is null */

        return 3;                                                                    /* return error */
    }
    if (handle->spi_init == NULL)                                                    /* check spi_init */
    {
        handle->debug_print("bmp280: spi_init is null.\n");                          /* spi_init is nul */

        return 3;                                                                    /* return error */
    }
    if (handle->spi_deinit == NULL)                                                  /* check spi_deinit */
    {
        handle->debug_print("bmp280: spi_deinit is null.\n");                        /* spi_deinit is nul */

        return 3;                                                                    /* return error */
    }
    if (handle->spi_read == NULL)                                                    /* check spi_read */
    {
        handle->debug_print("bmp280: spi_read is null.\n");                          /* spi_read is nul */

        return 3;                                                                    /* return error */
    }
    if (handle->spi_write == NULL)                                                   /* check spi_write */
    {
        handle->debug_print("bmp280: spi_write is null.\n");                         /* spi_write is nul */

        return 3;                                                                    /* return error */
    }
    if (handle->delay_ms == NULL)                                                    /* check delay_ms */
    {
        handle->debug_print("bmp280: delay_ms is null.\n");                          /* delay_ms is null */

        return 3;                                                                    /* return error */
    }

    if (handle->iic_spi == BMP280_INTERFACE_IIC)                                     /* iic interface */
    {
        if (handle->iic_init() != 0)                                                 /* iic init */
        {
            handle->debug_print("bmp280: iic init failed.\n");                       /* iic init failed */

            return 1;                                                                /* return error */
        }
    }
    else                                                                             /* spi interface */
    {
        if (handle->spi_init() != 0)                                                 /* spi init */
        {
            handle->debug_print("bmp280: spi init failed.\n");                       /* spi init failed */

            return 1;                                                                /* return error */
        }
    }

    if (a_bmp280_iic_spi_read(handle, BMP280_REG_ID, (uint8_t *)&id, 1) != 0)        /* read chip id */
    {
        handle->debug_print("bmp280: read id failed.\n");                            /* read id failed */
        if (handle->iic_spi == BMP280_INTERFACE_IIC)                                 /* iic interface */
        {
            (void)handle->iic_deinit();                                              /* iic deinit */
        }
        else                                                                         /* spi interface */
        {
            (void)handle->spi_deinit();                                              /* spi deinit */
        }
        
        return 4;                                                                    /* return error */
    }
    if (id != 0x58)                                                                  /* check id */
    {
        handle->debug_print("bmp280: id is error.\n");                               /* id is error */
        if (handle->iic_spi == BMP280_INTERFACE_IIC)                                 /* iic interface */
        {
            (void)handle->iic_deinit();                                              /* iic deinit */
        }
        else                                                                         /* spi interface */
        {
            (void)handle->spi_deinit();                                              /* spi deinit */
        }
        
        return 4;                                                                    /* return error */
    }
    reg = 0xB6;                                                                      /* set the reset value */
    if (a_bmp280_iic_spi_write(handle, BMP280_REG_RESET, &reg, 1) != 0)              /* reset the chip */
    {
        handle->debug_print("bmp280: reset failed.\n");                              /* reset failed */
        if (handle->iic_spi == BMP280_INTERFACE_IIC)                                 /* iic interface */
        {
            (void)handle->iic_deinit();                                              /* iic deinit */
        }
        else                                                                         /* spi interface */
        {
            (void)handle->spi_deinit();                                              /* spi deinit */
        }
        
        return 5;                                                                    /* return error */
    }
    handle->delay_ms(5);                                                             /* delay 5ms */
    if (a_bmp280_get_nvm_calibration(handle) != 0)                                   /* get nvm calibration */
    {
        if (handle->iic_spi == BMP280_INTERFACE_IIC)                                 /* iic interface */
        {
            (void)handle->iic_deinit();                                              /* iic deinit */
        }
        else                                                                         /* spi interface */
        {
            (void)handle->spi_deinit();                                              /* spi deinit */
        }
        
        return 6;                                                                    /* return error */
    }
    handle->inited = 1;                                                              /* flag finish initialization */

    return 0;                                                                        /* success return 0 */
}

/**
 * @brief     close the chip
 * @param[in] *handle pointer to a bmp280 handle structure
 * @return    status code
 *            - 0 success
 *            - 1 iic deinit failed
 *            - 2 handle is NULL
 *            - 3 handle is not initialized
 *            - 4 power down failed
 * @note      none
 */
uint8_t bmp280_deinit(bmp280_handle_t *handle)
{
    uint8_t prev;

    if (handle == NULL)                                                             /* check handle */
    {
        return 2;                                                                   /* return error */
    }
    if (handle->inited != 1)                                                        /* check handle initialization */
    {
        return 3;                                                                   /* return error */
    }

    if (a_bmp280_iic_spi_read(handle, BMP280_REG_CTRL_MEAS, &prev, 1) != 0)         /* read ctrl meas */
    {
        handle->debug_print("bmp280: read ctrl meas failed.\n");                    /* read ctrl meas failed */

        return 4;                                                                   /* return error */
    }
    prev &= ~(3 << 0);                                                              /* clear settings */
    prev |= 0 << 0;                                                                 /* set sleep mode */
    if (a_bmp280_iic_spi_write(handle, BMP280_REG_CTRL_MEAS, &prev, 1) != 0)        /* write ctrl meas */
    {
        handle->debug_print("bmp280: write ctrl meas failed.\n");                   /* write ctrl meas failed */

        return 4;                                                                   /* return error */
    }
    if (handle->iic_spi == BMP280_INTERFACE_IIC)                                    /* iic interface */
    {
        if (handle->iic_deinit() != 0)                                              /* iic deinit */
        {
            handle->debug_print("bmp280: iic deinit failed.\n");                    /* iic deinit failed */

            return 1;                                                               /* return error */
        }
    }
    else                                                                            /* spi interface */
    {
        if (handle->spi_deinit() != 0)                                              /* spi deinit */
        {
            handle->debug_print("bmp280: spi deinit failed.\n");                    /* spi deinit failed */

            return 1;                                                               /* return error */
        }
    }
    handle->inited = 0;                                                             /* flag close */

    return 0;                                                                       /* success return 0 */
}

/**
 * @brief     soft reset
 * @param[in] *handle pointer to a bmp280 handle structure
 * @return    status code
 *            - 0 success
 *            - 1 soft reset failed
 *            - 2 handle is NULL
 *            - 3 handle is not initialized
 * @note      none
 */
uint8_t bmp280_soft_reset(bmp280_handle_t *handle)
{
    uint8_t reg;

    if (handle == NULL)                                                        /* check handle */
    {
        return 2;                                                              /* return error */
    }
    if (handle->inited != 1)                                                   /* check handle initialization */
    {
        return 3;                                                              /* return error */
    }

    reg = 0xB6;                                                                /* set the reset value */
    if (a_bmp280_iic_spi_write(handle, BMP280_REG_RESET, &reg, 1) != 0)        /* reset the chip */
    {
        handle->debug_print("bmp280: reset failed.\n");                        /* reset failed */

        return 1;                                                              /* return error */
    }
    handle->delay_ms(5);                                                       /* delay 5ms */

    return 0;                                                                  /* success return 0 */
}

/**
 * @brief      get status
 * @param[in]  *handle pointer to a bmp280 handle structure
 * @param[out] *status pointer to a status buffer
 * @return     status code
 *             - 0 success
 *             - 1 get status failed
 *             - 2 handle is NULL
 *             - 3 handle is not initialized
 * @note       none
 */
uint8_t bmp280_get_status(bmp280_handle_t *handle, uint8_t *status)
{
    if (handle == NULL)                                                        /* check handle */
    {
        return 2;                                                              /* return error */
    }
    if (handle->inited != 1)                                                   /* check handle initialization */
    {
        return 3;                                                              /* return error */
    }

    if (a_bmp280_iic_spi_read(handle, BMP280_REG_STATUS, status, 1) != 0)      /* read status */
    {
        handle->debug_print("bmp280: read status failed.\n");                  /* read status failed */

        return 1;                                                              /* return error */
    }

    return 0;                                                                  /* success return 0 */
}

/**
 * @brief     set temperature oversampling
 * @param[in] *handle pointer to a bmp280 handle structure
 * @param[in] oversampling temperature oversampling
 * @return    status code
 *            - 0 success
 *            - 1 set temperature oversampling failed
 *            - 2 handle is NULL
 *            - 3 handle is not initialized
 * @note      none
 */
uint8_t bmp280_set_temperature_oversampling(bmp280_handle_t *handle, bmp280_oversampling_t oversampling)
{
    uint8_t prev;

    if (handle == NULL)                                                        /* check handle */
    {
        return 2;                                                              /* return error */
    }
    if (handle->inited != 1)                                                   /* check handle initialization */
    {
        return 3;                                                              /* return error */
    }

    if (a_bmp280_iic_spi_read(handle, BMP280_REG_CTRL_MEAS, &prev, 1) != 0)    /* read ctrl meas */
    {
        handle->debug_print("bmp280: read ctrl meas failed.\n");               /* read ctrl meas failed */

        return 1;                                                              /* return error */
    }
    prev &= ~(7 << 5);                                                         /* clear settings */
    prev |= oversampling << 5;                                                 /* set oversampling */
    if (a_bmp280_iic_spi_write(handle, BMP280_REG_CTRL_MEAS, &prev, 1) != 0)   /* write ctrl meas */
    {
        handle->debug_print("bmp280: write ctrl meas failed.\n");              /* write ctrl meas failed */

        return 1;                                                              /* return error */
    }

    return 0;                                                                  /* success return 0 */
}

/**
 * @brief      get temperature oversampling
 * @param[in]  *handle pointer to a bmp280 handle structure
 * @param[out] *oversampling pointer to a oversampling buffer
 * @return     status code
 *             - 0 success
 *             - 1 get temperature oversampling failed
 *             - 2 handle is NULL
 *             - 3 handle is not initialized
 * @note       none
 */
uint8_t bmp280_get_temperature_oversampling(bmp280_handle_t *handle, bmp280_oversampling_t *oversampling)
{
    uint8_t prev;

    if (handle == NULL)                                                        /* check handle */
    {
        return 2;                                                              /* return error */
    }
    if (handle->inited != 1)                                                   /* check handle initialization */
    {
        return 3;                                                              /* return error */
    }

    if (a_bmp280_iic_spi_read(handle, BMP280_REG_CTRL_MEAS, &prev, 1) != 0)    /* read ctrl meas */
    {
        handle->debug_print("bmp280: read ctrl meas failed.\n");               /* read ctrl meas failed */

        return 1;                                                              /* return error */
    }
    *oversampling = (bmp280_oversampling_t)((prev >> 5) & 0x7);                /* set oversampling */

    return 0;                                                                  /* success return 0 */
}

/**
 * @brief     set pressure oversampling
 * @param[in] *handle pointer to a bmp280 handle structure
 * @param[in] oversampling pressure oversampling
 * @return    status code
 *            - 0 success
 *            - 1 set pressure oversampling failed
 *            - 2 handle is NULL
 *            - 3 handle is not initialized
 * @note      none
 */
uint8_t bmp280_set_pressure_oversampling(bmp280_handle_t *handle, bmp280_oversampling_t oversampling)
{
    uint8_t prev;

    if (handle == NULL)                                                        /* check handle */
    {
        return 2;                                                              /* return error */
    }
    if (handle->inited != 1)                                                   /* check handle initialization */
    {
        return 3;                                                              /* return error */
    }

    if (a_bmp280_iic_spi_read(handle, BMP280_REG_CTRL_MEAS, &prev, 1) != 0)    /* read ctrl meas */
    {
        handle->debug_print("bmp280: read ctrl meas failed.\n");               /* read ctrl meas failed */

        return 1;                                                              /* return error */
    }
    prev &= ~(7 << 2);                                                         /* clear settings */
    prev |= oversampling << 2;                                                 /* set oversampling */
    if (a_bmp280_iic_spi_write(handle, BMP280_REG_CTRL_MEAS, &prev, 1) != 0)   /* write ctrl meas */
    {
        handle->debug_print("bmp280: write ctrl meas failed.\n");              /* write ctrl meas failed */

        return 1;                                                              /* return error */
    }

    return 0;                                                                  /* success return 0 */
}

/**
 * @brief      get pressure oversampling
 * @param[in]  *handle pointer to a bmp280 handle structure
 * @param[out] *oversampling pointer to a oversampling buffer
 * @return     status code
 *             - 0 success
 *             - 1 get pressure oversampling failed
 *             - 2 handle is NULL
 *             - 3 handle is not initialized
 * @note       none
 */
uint8_t bmp280_get_pressure_oversampling(bmp280_handle_t *handle, bmp280_oversampling_t *oversampling)
{
    uint8_t prev;

    if (handle == NULL)                                                        /* check handle */
    {
        return 2;                                                              /* return error */
    }
    if (handle->inited != 1)                                                   /* check handle initialization */
    {
        return 3;                                                              /* return error */
    }

    if (a_bmp280_iic_spi_read(handle, BMP280_REG_CTRL_MEAS, &prev, 1) != 0)    /* read ctrl meas */
    {
        handle->debug_print("bmp280: read ctrl meas failed.\n");               /* read ctrl meas failed */

        return 1;                                                              /* return error */
    }
    *oversampling = (bmp280_oversampling_t)((prev >> 2) & 0x7);                /* set oversampling */

    return 0;                                                                  /* success return 0 */
}

/**
 * @brief     set mode
 * @param[in] *handle pointer to a bmp280 handle structure
 * @param[in] mode chip mode
 * @return    status code
 *            - 0 success
 *            - 1 set mode failed
 *            - 2 handle is NULL
 *            - 3 handle is not initialized
 * @note      none
 */
uint8_t bmp280_set_mode(bmp280_handle_t *handle, bmp280_mode_t mode)
{
    uint8_t prev;

    if (handle == NULL)                                                             /* check handle */
    {
        return 2;                                                                   /* return error */
    }
    if (handle->inited != 1)                                                        /* check handle initialization */
    {
        return 3;                                                                   /* return error */
    }

    if (a_bmp280_iic_spi_read(handle, BMP280_REG_CTRL_MEAS, &prev, 1) != 0)         /* read ctrl meas */
    {
        handle->debug_print("bmp280: read ctrl meas failed.\n");                    /* read ctrl meas failed */

        return 1;                                                                   /* return error */
    }
    prev &= ~(3 << 0);                                                              /* clear settings */
    prev |= mode << 0;                                                              /* set mode */
    if (a_bmp280_iic_spi_write(handle, BMP280_REG_CTRL_MEAS, &prev, 1) != 0)        /* write ctrl meas */
    {
        handle->debug_print("bmp280: write ctrl meas failed.\n");                   /* write ctrl meas failed */

        return 1;                                                                   /* return error */
    }

    return 0;                                                                       /* success return 0 */
}

/**
 * @brief      get mode
 * @param[in]  *handle pointer to a bmp280 handle structure
 * @param[out] *mode pointer to a mode buffer
 * @return     status code
 *             - 0 success
 *             - 1 get mode failed
 *             - 2 handle is NULL
 *             - 3 handle is not initialized
 * @note       none
 */
uint8_t bmp280_get_mode(bmp280_handle_t *handle, bmp280_mode_t *mode)
{
    uint8_t prev;

    if (handle == NULL)                                                        /* check handle */
    {
        return 2;                                                              /* return error */
    }
    if (handle->inited != 1)                                                   /* check handle initialization */
    {
        return 3;                                                              /* return error */
    }

    if (a_bmp280_iic_spi_read(handle, BMP280_REG_CTRL_MEAS, &prev, 1) != 0)    /* read ctrl meas */
    {
        handle->debug_print("bmp280: read ctrl meas failed.\n");               /* read ctrl meas failed */

        return 1;                                                              /* return error */
    }
    *mode = (bmp280_mode_t)((prev >> 0) & 0x3);                                /* set mode */

    return 0;                                                                  /* success return 0 */
}

/**
 * @brief     set standby time
 * @param[in] *handle pointer to a bmp280 handle structure
 * @param[in] standby_time standby time
 * @return    status code
 *            - 0 success
 *            - 1 set standby time failed
 *            - 2 handle is NULL
 *            - 3 handle is not initialized
 * @note      none
 */
uint8_t bmp280_set_standby_time(bmp280_handle_t *handle, bmp280_standby_time_t standby_time)
{
    uint8_t prev;

    if (handle == NULL)                                                          /* check handle */
    {
        return 2;                                                                /* return error */
    }
    if (handle->inited != 1)                                                     /* check handle initialization */
    {
        return 3;                                                                /* return error */
    }

    if (a_bmp280_iic_spi_read(handle, BMP280_REG_CONFIG, &prev, 1) != 0)         /* read config */
    {
        handle->debug_print("bmp280: read config failed.\n");                    /* read config failed */

        return 1;                                                                /* return error */
    }
    prev &= ~(7 << 5);                                                           /* clear settings */
    prev |= standby_time << 5;                                                   /* set standby time */
    if (a_bmp280_iic_spi_write(handle, BMP280_REG_CONFIG, &prev, 1) != 0)        /* write config */
    {
        handle->debug_print("bmp280: write config failed.\n");                   /* write config failed */

        return 1;                                                                /* return error */
    }

    return 0;                                                                    /* success return 0 */
}

/**
 * @brief      get standby time
 * @param[in]  *handle pointer to a bmp280 handle structure
 * @param[out] *standby_time pointer to a standby time buffer
 * @return     status code
 *             - 0 success
 *             - 1 get standby time failed
 *             - 2 handle is NULL
 *             - 3 handle is not initialized
 * @note       none
 */
uint8_t bmp280_get_standby_time(bmp280_handle_t *handle, bmp280_standby_time_t *standby_time)
{
    uint8_t prev;

    if (handle == NULL)                                                         /* check handle */
    {
        return 2;                                                               /* return error */
    }
    if (handle->inited != 1)                                                    /* check handle initialization */
    {
        return 3;                                                               /* return error */
    }

    if (a_bmp280_iic_spi_read(handle, BMP280_REG_CONFIG, &prev, 1) != 0)        /* read config */
    {
        handle->debug_print("bmp280: read config failed.\n");                   /* read config failed */

        return 1;                                                               /* return error */
    }
    *standby_time = (bmp280_standby_time_t)((prev >> 5) & 0x7);                 /* get standby time */

    return 0;                                                                   /* success return 0 */
}

/**
 * @brief     set filter
 * @param[in] *handle pointer to a bmp280 handle structure
 * @param[in] filter input filter
 * @return    status code
 *            - 0 success
 *            - 1 set filter failed
 *            - 2 handle is NULL
 *            - 3 handle is not initialized
 * @note      none
 */
uint8_t bmp280_set_filter(bmp280_handle_t *handle, bmp280_filter_t filter)
{
    uint8_t prev;

    if (handle == NULL)                                                          /* check handle */
    {
        return 2;                                                                /* return error */
    }
    if (handle->inited != 1)                                                     /* check handle initialization */
    {
        return 3;                                                                /* return error */
    }

    if (a_bmp280_iic_spi_read(handle, BMP280_REG_CONFIG, &prev, 1) != 0)         /* read config */
    {
        handle->debug_print("bmp280: read config failed.\n");                    /* read config failed */

        return 1;                                                                /* return error */
    }
    prev &= ~(7 << 2);                                                           /* clear settings */
    prev |= (filter & 0x07) << 2;                                                /* set filter */
    if (a_bmp280_iic_spi_write(handle, BMP280_REG_CONFIG, &prev, 1) != 0)        /* write config */
    {
        handle->debug_print("bmp280: write config failed.\n");                   /* write config failed */

        return 1;                                                                /* return error */
    }

    return 0;                                                                    /* success return 0 */
}

/**
 * @brief      get filter
 * @param[in]  *handle pointer to a bmp280 handle structure
 * @param[out] *filter pointer to a filter buffer
 * @return     status code
 *             - 0 success
 *             - 1 get filter failed
 *             - 2 handle is NULL
 *             - 3 handle is not initialized
 * @note       none
 */
uint8_t bmp280_get_filter(bmp280_handle_t *handle, bmp280_filter_t *filter)
{
    uint8_t prev;

    if (handle == NULL)                                                          /* check handle */
    {
        return 2;                                                                /* return error */
    }
    if (handle->inited != 1)                                                     /* check handle initialization */
    {
        return 3;                                                                /* return error */
    }

    if (a_bmp280_iic_spi_read(handle, BMP280_REG_CONFIG, &prev, 1) != 0)         /* read config */
    {
        handle->debug_print("bmp280: read config failed.\n");                    /* read config failed */

        return 1;                                                                /* return error */
    }
    *filter = (bmp280_filter_t)((prev >> 2) & 0x07);                             /* set filter */

    return 0;                                                                    /* success return 0 */
}

/**
 * @brief     set spi wire
 * @param[in] *handle pointer to a bmp280 handle structure
 * @param[in] spi spi wire
 * @return    status code
 *            - 0 success
 *            - 1 set spi wire failed
 *            - 2 handle is NULL
 *            - 3 handle is not initialized
 * @note      none
 */
uint8_t bmp280_set_spi_wire(bmp280_handle_t *handle, bmp280_spi_wire_t spi)
{
    uint8_t prev;

    if (handle == NULL)                                                          /* check handle */
    {
        return 2;                                                                /* return error */
    }
    if (handle->inited != 1)                                                     /* check handle initialization */
    {
        return 3;                                                                /* return error */
    }

    if (a_bmp280_iic_spi_read(handle, BMP280_REG_CONFIG, &prev, 1) != 0)         /* read config */
    {
        handle->debug_print("bmp280: read config failed.\n");                    /* read config failed */

        return 1;                                                                /* return error */
    }
    prev &= ~(1 << 0);                                                           /* clear settings */
    prev |= spi << 0;                                                            /* set spi wire */
    if (a_bmp280_iic_spi_write(handle, BMP280_REG_CONFIG, &prev, 1) != 0)        /* write config */
    {
        handle->debug_print("bmp280: write config failed.\n");                   /* write config failed */

        return 1;                                                                /* return error */
    }

    return 0;                                                                    /* success return 0 */
}

/**
 * @brief      get spi wire
 * @param[in]  *handle pointer to a bmp280 handle structure
 * @param[out] *spi pointer to a spi wire buffer
 * @return     status code
 *             - 0 success
 *             - 1 get spi wire failed
 *             - 2 handle is NULL
 *             - 3 handle is not initialized
 * @note       none
 */
uint8_t bmp280_get_spi_wire(bmp280_handle_t *handle, bmp280_spi_wire_t *spi)
{
    uint8_t prev;

    if (handle == NULL)                                                          /* check handle */
    {
        return 2;                                                                /* return error */
    }
    if (handle->inited != 1)                                                     /* check handle initialization */
    {
        return 3;                                                                /* return error */
    }

    if (a_bmp280_iic_spi_read(handle, BMP280_REG_CONFIG, &prev, 1) != 0)         /* read config */
    {
        handle->debug_print("bmp280: read config failed.\n");                    /* read config failed */

        return 1;                                                                /* return error */
    }
    *spi = (bmp280_spi_wire_t)((prev >> 0) & 0x01);                              /* get spi */

    return 0;                                                                    /* success return 0 */
}

/**
 * @brief      read the pressure data
 * @param[in]  *handle pointer to a bmp280 handle structure
 * @param[out] *pressure_raw pointer to a raw pressure buffer
 * @param[out] *pressure_pa pointer to a converted pressure buffer
 * @return     status code
 *             - 0 success
 *             - 1 pressure read failed
 *             - 2 handle is NULL
 *             - 3 handle is not initialized
 *             - 4 compensate pressure failed
 *             - 5 read timeout
 * @note       none
 */
uint8_t bmp280_read_pressure(bmp280_handle_t *handle, uint32_t *pressure_raw, float *pressure_pa)
{
    uint8_t res;
    uint8_t prev;
    uint32_t timeout;
    uint32_t temperature_raw;
    float temperature_c;
    uint8_t buf[6];

    if (handle == NULL)                                                                        /* check handle */
    {
        return 2;                                                                              /* return error */
    }
    if (handle->inited != 1)                                                                   /* check handle initialization */
    {
        return 3;                                                                              /* return error */
    }

    if (a_bmp280_iic_spi_read(handle, BMP280_REG_CTRL_MEAS, &prev, 1) != 0)                    /* read ctrl meas */
    {
        handle->debug_print("bmp280: read ctrl meas failed.\n");                               /* read ctrl meas failed */

        return 1;                                                                              /* return error */
    }
    if ((prev & 0x3) == 3)                                                                     /* normal mode */
    {
        res = a_bmp280_iic_spi_read(handle, BMP280_REG_PRESS_MSB, buf, 6);                     /* read temperature and pressure */
        if (res != 0)
        {
            handle->debug_print("bmp280: read failed.\n");                                     /* read failed */

            return 1;                                                                          /* return error */
        }
        temperature_raw = ((((uint32_t)(buf[3])) << 12) |
                          (((uint32_t)(buf[4])) << 4) |
                          ((uint32_t)buf[5] >> 4));                                            /* set temperature raw */
        res = a_bmp280_compensate_temperature(handle, temperature_raw, &temperature_c);        /* compensate temperature */
        if (res != 0)
        {
            handle->debug_print("bmp280: compensate temperature failed.\n");                   /* compensate temperature failed */

            return 4;                                                                          /* return error */
        }
        *pressure_raw = ((((int32_t)(buf[0])) << 12) |
                        (((int32_t)(buf[1])) << 4) |
                        (((int32_t)(buf[2])) >> 4));                                           /* set pressure raw */
        res = a_bmp280_compensate_pressure(handle, *pressure_raw, pressure_pa);                /* compensate pressure */
        if (res != 0)
        {
            handle->debug_print("bmp280: compensate pressure failed.\n");                      /* compensate pressure failed */

            return 4;                                                                          /* return error */
        }
    }
    else                                                                                       /* forced mode */
    {
        if (a_bmp280_iic_spi_read(handle, BMP280_REG_CTRL_MEAS, &prev, 1) != 0)                /* read ctrl meas */
        {
            handle->debug_print("bmp280: read ctrl meas failed.\n");                           /* read ctrl meas failed */

            return 1;                                                                          /* return error */
        }
        prev &= ~(3 << 0);                                                                     /* clear settings */
        prev |= 0x01 << 0;                                                                     /* set forced mode */
        if (a_bmp280_iic_spi_write(handle, BMP280_REG_CTRL_MEAS, &prev, 1) != 0)               /* write ctrl meas */
        {
            handle->debug_print("bmp280: write ctrl meas failed.\n");                          /* write ctrl meas failed */

            return 1;                                                                          /* return error */
        }
        timeout = 10 * 1000;                                                                   /* set timeout */
        while (timeout != 0)                                                                   /* check timeout */
        {
            if (a_bmp280_iic_spi_read(handle, BMP280_REG_CTRL_MEAS, &prev, 1) != 0)            /* read ctrl meas */
            {
                handle->debug_print("bmp280: read ctrl meas failed.\n");                       /* read ctrl meas failed */

                return 1;                                                                      /* return error */
            }
            if ((prev & 0x03) == 0)                                                            /* if finished */
            {
                break;                                                                         /* break */
            }
            handle->delay_ms(1);                                                               /* delay 1ms */
            timeout--;                                                                         /* timeout-- */
        }
        if (timeout == 0)                                                                      /* check timeout */
        {
            handle->debug_print("bmp280: read timeout.\n");                                    /* read timeout */

            return 5;                                                                          /* return error */
        }
        res = a_bmp280_iic_spi_read(handle, BMP280_REG_PRESS_MSB, buf, 6);                     /* read temperature and pressure */
        if (res != 0)
        {
            handle->debug_print("bmp280: read failed.\n");                                     /* read failed */

            return 1;                                                                          /* return error */
        }
        temperature_raw = ((((uint32_t)(buf[3])) << 12) |
                          (((uint32_t)(buf[4])) << 4) |
                          ((uint32_t)buf[5] >> 4));                                            /* set temperature raw */
        res = a_bmp280_compensate_temperature(handle, temperature_raw, &temperature_c);        /* compensate temperature */
        if (res != 0)
        {
            handle->debug_print("bmp280: compensate temperature failed.\n");                   /* compensate temperature failed */

            return 4;                                                                          /* return error */
        }
        *pressure_raw = ((((int32_t)(buf[0])) << 12) |
                        (((int32_t)(buf[1])) << 4) |
                        (((int32_t)(buf[2])) >> 4));                                           /* set pressure raw */
        res = a_bmp280_compensate_pressure(handle, *pressure_raw, pressure_pa);                /* compensate pressure */
        if (res != 0)
        {
            handle->debug_print("bmp280: compensate pressure failed.\n");                      /* compensate pressure failed */

            return 4;                                                                          /* return error */
        }
    }

    return 0;                                                                                  /* success return 0 */
}

/**
 * @brief      read the temperature data
 * @param[in]  *handle pointer to a bmp280 handle structure
 * @param[out] *temperature_raw pointer to a raw temperature buffer
 * @param[out] *temperature_c pointer to a converted temperature buffer
 * @return     status code
 *             - 0 success
 *             - 1 temperature read failed
 *             - 2 handle is NULL
 *             - 3 handle is not initialized
 *             - 4 compensate pressure failed
 *             - 5 read timeout
 * @note       none
 */
uint8_t bmp280_read_temperature(bmp280_handle_t *handle, uint32_t *temperature_raw, float *temperature_c)
{
    uint8_t res;
    uint8_t prev;
    uint32_t timeout;
    uint8_t buf[6];

    if (handle == NULL)                                                                        /* check handle */
    {
        return 2;                                                                              /* return error */
    }
    if (handle->inited != 1)                                                                   /* check handle initialization */
    {
        return 3;                                                                              /* return error */
    }

    if (a_bmp280_iic_spi_read(handle, BMP280_REG_CTRL_MEAS, &prev, 1) != 0)                    /* read ctrl meas */
    {
        handle->debug_print("bmp280: read ctrl meas failed.\n");                               /* read ctrl meas failed */

        return 1;                                                                              /* return error */
    }
    if ((prev & 0x3) == 3)                                                                     /* normal mode */
    {
        res = a_bmp280_iic_spi_read(handle, BMP280_REG_PRESS_MSB, buf, 6);                     /* read temperature and pressure */
        if (res != 0)
        {
            handle->debug_print("bmp280: read failed.\n");                                     /* read failed */

            return 1;                                                                          /* return error */
        }
        *temperature_raw = ((((uint32_t)(buf[3])) << 12) |
                           (((uint32_t)(buf[4])) << 4) |
                           ((uint32_t)buf[5] >> 4));                                           /* set temperature raw */
        res = a_bmp280_compensate_temperature(handle, *temperature_raw, temperature_c);        /* compensate temperature */
        if (res != 0)
        {
            handle->debug_print("bmp280: compensate temperature failed.\n");                   /* compensate temperature failed */

            return 4;                                                                          /* return error */
        }
    }
    else                                                                                       /* forced mode */
    {
        if (a_bmp280_iic_spi_read(handle, BMP280_REG_CTRL_MEAS, &prev, 1) != 0)                /* read ctrl meas */
        {
            handle->debug_print("bmp280: read ctrl meas failed.\n");                           /* read ctrl meas failed */

            return 1;                                                                          /* return error */
        }
        prev &= ~(3 << 0);                                                                     /* clear settings */
        prev |= 0x01 << 0;                                                                     /* set forced mode */
        if (a_bmp280_iic_spi_write(handle, BMP280_REG_CTRL_MEAS, &prev, 1) != 0)               /* write ctrl meas */
        {
            handle->debug_print("bmp280: write ctrl meas failed.\n");                          /* write ctrl meas failed */

            return 1;                                                                          /* return error */
        }
        timeout = 10 * 1000;                                                                   /* set timeout */
        while (timeout != 0)                                                                   /* check timeout */
        {
            if (a_bmp280_iic_spi_read(handle, BMP280_REG_CTRL_MEAS, &prev, 1) != 0)            /* read ctrl meas */
            {
                handle->debug_print("bmp280: read ctrl meas failed.\n");                       /* read ctrl meas failed */

                return 1;                                                                      /* return error */
            }
            if ((prev & 0x03) == 0)                                                            /* if finished */
            {
                break;                                                                         /* break */
            }
            handle->delay_ms(1);                                                               /* delay 1ms */
            timeout--;                                                                         /* timeout-- */
        }
        if (timeout == 0)                                                                      /* check timeout */
        {
            handle->debug_print("bmp280: read timeout.\n");                                    /* read timeout */

            return 5;                                                                          /* return error */
        }
        res = a_bmp280_iic_spi_read(handle, BMP280_REG_PRESS_MSB, buf, 6);                     /* read temperature and pressure */
        if (res != 0)
        {
            handle->debug_print("bmp280: read failed.\n");                                     /* read failed */

            return 1;                                                                          /* return error */
        }
        *temperature_raw = ((((uint32_t)(buf[3])) << 12) |
                           (((uint32_t)(buf[4])) << 4) |
                           ((uint32_t)buf[5] >> 4));                                           /* set temperature raw */
        res = a_bmp280_compensate_temperature(handle, *temperature_raw, temperature_c);        /* compensate temperature */
        if (res != 0)
        {
            handle->debug_print("bmp280: compensate temperature failed.\n");                   /* compensate temperature failed */

            return 4;                                                                          /* return error */
        }
    }

    return 0;                                                                                  /* success return 0 */
}

/**
 * @brief      read the temperature and pressure data
 * @param[in]  *handle pointer to a bmp280 handle structure
 * @param[out] *temperature_raw pointer to a raw temperature buffer
 * @param[out] *temperature_c pointer to a converted temperature buffer
 * @param[out] *pressure_raw pointer to a raw pressure buffer
 * @param[out] *pressure_pa pointer to a converted pressure buffer
 * @return     status code
 *             - 0 success
 *             - 1 read failed
 *             - 2 handle is NULL
 *             - 3 handle is not initialized
 *             - 4 compensate pressure failed
 *             - 5 read timeout
 * @note       none
 */
uint8_t bmp280_read_temperature_pressure(bmp280_handle_t *handle, uint32_t *temperature_raw, float *temperature_c,
                                         uint32_t *pressure_raw, float *pressure_pa)
{
    uint8_t res;
    uint8_t prev;
    uint32_t timeout;
    uint8_t buf[6];

    if (handle == NULL)                                                                        /* check handle */
    {
        return 2;                                                                              /* return error */
    }
    if (handle->inited != 1)                                                                   /* check handle initialization */
    {
        return 3;                                                                              /* return error */
    }

    if (a_bmp280_iic_spi_read(handle, BMP280_REG_CTRL_MEAS, &prev, 1) != 0)                    /* read ctrl meas */
    {
        handle->debug_print("bmp280: read ctrl meas failed.\n");                               /* read ctrl meas failed */

        return 1;                                                                              /* return error */
    }
    if ((prev & 0x3) == 3)                                                                     /* normal mode */
    {
        res = a_bmp280_iic_spi_read(handle, BMP280_REG_PRESS_MSB, buf, 6);                     /* read temperature and pressure */
        if (res != 0)
        {
            handle->debug_print("bmp280: read failed.\n");                                     /* read failed */

            return 1;                                                                          /* return error */
        }
        *temperature_raw = ((((uint32_t)(buf[3])) << 12) |
                           (((uint32_t)(buf[4])) << 4) |
                           ((uint32_t)buf[5] >> 4));                                           /* set temperature raw */
        res = a_bmp280_compensate_temperature(handle, *temperature_raw, temperature_c);        /* compensate temperature */
        if (res != 0)
        {
            handle->debug_print("bmp280: compensate temperature failed.\n");                   /* compensate temperature failed */

            return 4;                                                                          /* return error */
        }
        *pressure_raw = ((((int32_t)(buf[0])) << 12) |
                        (((int32_t)(buf[1])) << 4) |
                        (((int32_t)(buf[2])) >> 4));                                           /* set pressure raw */
        res = a_bmp280_compensate_pressure(handle, *pressure_raw, pressure_pa);                /* compensate pressure */
        if (res != 0)
        {
            handle->debug_print("bmp280: compensate pressure failed.\n");                      /* compensate pressure failed */

            return 4;                                                                          /* return error */
        }
    }
    else                                                                                       /* forced mode */
    {
        if (a_bmp280_iic_spi_read(handle, BMP280_REG_CTRL_MEAS, &prev, 1) != 0)                /* read ctrl meas */
        {
            handle->debug_print("bmp280: read ctrl meas failed.\n");                           /* read ctrl meas failed */

            return 1;                                                                          /* return error */
        }
        prev &= ~(3 << 0);                                                                     /* clear settings */
        prev |= 0x01 << 0;                                                                     /* set forced mode */
        if (a_bmp280_iic_spi_write(handle, BMP280_REG_CTRL_MEAS, &prev, 1) != 0)               /* write ctrl meas */
        {
            handle->debug_print("bmp280: write ctrl meas failed.\n");                          /* write ctrl meas failed */

            return 1;                                                                          /* return error */
        }
        timeout = 10 * 1000;                                                                   /* set timeout */
        while (timeout != 0)                                                                   /* check timeout */
        {
            if (a_bmp280_iic_spi_read(handle, BMP280_REG_CTRL_MEAS, &prev, 1) != 0)            /* read ctrl meas */
            {
                handle->debug_print("bmp280: read ctrl meas failed.\n");                       /* read ctrl meas failed */

                return 1;                                                                      /* return error */
            }
            if ((prev & 0x03) == 0)                                                            /* if finished */
            {
                break;                                                                         /* break */
            }
            handle->delay_ms(1);                                                               /* delay 1ms */
            timeout--;                                                                         /* timeout-- */
        }
        if (timeout == 0)                                                                      /* check timeout */
        {
            handle->debug_print("bmp280: read timeout.\n");                                    /* read timeout */

            return 5;                                                                          /* return error */
        }
        res = a_bmp280_iic_spi_read(handle, BMP280_REG_PRESS_MSB, buf, 6);                     /* read temperature and pressure */
        if (res != 0)
        {
            handle->debug_print("bmp280: read failed.\n");                                     /* read failed */

            return 1;                                                                          /* return error */
        }
        *temperature_raw = ((((uint32_t)(buf[3])) << 12) |
                           (((uint32_t)(buf[4])) << 4) |
                           ((uint32_t)buf[5] >> 4));                                           /* set temperature raw */
        res = a_bmp280_compensate_temperature(handle, *temperature_raw, temperature_c);        /* compensate temperature */
        if (res != 0)
        {
            handle->debug_print("bmp280: compensate temperature failed.\n");                   /* compensate temperature failed */

            return 4;                                                                          /* return error */
        }
        *pressure_raw = ((((int32_t)(buf[0])) << 12) |
                        (((int32_t)(buf[1])) << 4) |
                        (((int32_t)(buf[2])) >> 4));                                           /* set pressure raw */
        res = a_bmp280_compensate_pressure(handle, *pressure_raw, pressure_pa);                /* compensate pressure */
        if (res != 0)
        {
            handle->debug_print("bmp280: compensate pressure failed.\n");                      /* compensate pressure failed */

            return 4;                                                                          /* return error */
        }
    }

    return 0;                                                                                  /* success return 0 */
}

/**
 * @brief     set the chip register
 * @param[in] *handle pointer to a bmp280 handle structure
 * @param[in] reg iic register address
 * @param[in] value data written to the register
 * @return    status code
 *            - 0 success
 *            - 1 write failed
 *            - 2 handle is NULL
 *            - 3 handle is not initialized
 * @note      none
 */
uint8_t bmp280_set_reg(bmp280_handle_t *handle, uint8_t reg, uint8_t value)
{
    if (handle == NULL)                                          /* check handle */
    {
        return 2;                                                /* return error */
    }
    if (handle->inited != 1)                                     /* check handle initialization */
    {
        return 3;                                                /* return error */
    }

    return a_bmp280_iic_spi_write(handle, reg, &value, 1);       /* write register */
}

/**
 * @brief      get the chip register
 * @param[in]  *handle pointer to a bmp280 handle structure
 * @param[in]  reg iic register address
 * @param[out] *value pointer to a read data buffer
 * @return     status code
 *             - 0 success
 *             - 1 read failed
 *             - 2 handle is NULL
 *             - 3 handle is not initialized
 * @note       none
 */
uint8_t bmp280_get_reg(bmp280_handle_t *handle, uint8_t reg, uint8_t *value)
{
    if (handle == NULL)                                        /* check handle */
    {
        return 2;                                              /* return error */
    }
    if (handle->inited != 1)                                   /* check handle initialization */
    {
        return 3;                                              /* return error */
    }

    return a_bmp280_iic_spi_read(handle, reg, value, 1);       /* read register */
}

/**
 * @brief      get chip's information
 * @param[out] *info pointer to a bmp280 info structure
 * @return     status code
 *             - 0 success
 *             - 2 handle is NULL
 * @note       none
 */
uint8_t bmp280_info(bmp280_info_t *info)
{
    if (info == NULL)                                               /* check handle */
    {
        return 2;                                                   /* return error */
    }

    memset(info, 0, sizeof(bmp280_info_t));                         /* initialize bmp280 info structure */
    strncpy(info->chip_name, CHIP_NAME, 32);                        /* copy chip name */
    strncpy(info->manufacturer_name, MANUFACTURER_NAME, 32);        /* copy manufacturer name */
    strncpy(info->interface, "IIC SPI", 8);                         /* copy interface name */
    info->supply_voltage_min_v = SUPPLY_VOLTAGE_MIN;                /* set minimal supply voltage */
    info->supply_voltage_max_v = SUPPLY_VOLTAGE_MAX;                /* set maximum supply voltage */
    info->max_current_ma = MAX_CURRENT;                             /* set maximum current */
    info->temperature_max = TEMPERATURE_MAX;                        /* set minimal temperature */
    info->temperature_min = TEMPERATURE_MIN;                        /* set maximum temperature */
    info->driver_version = DRIVER_VERSION;                          /* set driver version */

    return 0;                                                       /* success return 0 */
}
