Cosmo1233/CosFly/components/drivers/i2c_bus/i2cdev_esp32.c

/**
 *
 * ESP-Drone Firmware
 *
 * Copyright 2019-2020  Espressif Systems (Shanghai)
 * Copyright (C) 2011-2012 Bitcraze AB
 *
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
 *
 * i2cdev.c - Functions to write to I2C devices
 */
#define DEBUG_MODULE "I2CDEV"

#include <stdint.h>
#include <stdbool.h>

#include "freertos/FreeRTOS.h"
#include "freertos/semphr.h"
#include "freertos/task.h"
#include "freertos/queue.h"

#include "stm32_legacy.h"
#include "i2cdev.h"
#include "i2c_drv.h"
#include "nvicconf.h"
#include "debug_cf.h"

int i2cdevInit(I2C_Dev *dev)
{
    i2cdrvInit(dev);
    return true;
}

bool i2cdevRead(I2C_Dev *dev, uint8_t devAddress, uint16_t len, uint8_t *data)
{
    return i2cdevReadReg8(dev, devAddress, I2CDEV_NO_MEM_ADDR, len, data);
}

// Declared in i2cdev.h but never implemented upstream; needed by drivers that
// put the register byte in the data buffer themselves (e.g. PCA9534).
bool i2cdevWrite(I2C_Dev *dev, uint8_t devAddress, uint16_t len, uint8_t *data)
{
    return i2cdevWriteReg8(dev, devAddress, I2CDEV_NO_MEM_ADDR, len, data);
}

bool i2cdevReadByte(I2C_Dev *dev, uint8_t devAddress, uint8_t memAddress,
                    uint8_t *data)
{
    return i2cdevReadReg8(dev, devAddress, memAddress, 1, data);
}

bool i2cdevReadBit(I2C_Dev *dev, uint8_t devAddress, uint8_t memAddress,
                   uint8_t bitNum, uint8_t *data)
{
    uint8_t byte;
    bool status;

    status = i2cdevReadReg8(dev, devAddress, memAddress, 1, &byte);
    *data = byte & (1 << bitNum);

    return status;
}

bool i2cdevReadBits(I2C_Dev *dev, uint8_t devAddress, uint8_t memAddress,
                    uint8_t bitStart, uint8_t length, uint8_t *data)
{
    bool status;
    uint8_t byte;

    if ((status = i2cdevReadByte(dev, devAddress, memAddress, &byte)) == true) {
        uint8_t mask = ((1 << length) - 1) << (bitStart - length + 1);
        byte &= mask;
        byte >>= (bitStart - length + 1);
        *data = byte;
    }

    return status;
}

bool i2cdevReadReg8(I2C_Dev *dev, uint8_t devAddress, uint8_t memAddress,
                    uint16_t len, uint8_t *data)
{
    if (xSemaphoreTake(dev->isBusFreeMutex, (TickType_t)5) == pdFALSE) {
        return false;
    }

    i2c_cmd_handle_t cmd = i2c_cmd_link_create();
    if (memAddress != I2CDEV_NO_MEM_ADDR) {
        i2c_master_start(cmd);
        i2c_master_write_byte(cmd, (devAddress << 1) | I2C_MASTER_WRITE, I2C_MASTER_ACK_EN);
        i2c_master_write_byte(cmd, memAddress, I2C_MASTER_ACK_EN);
    }
    i2c_master_start(cmd);
    i2c_master_write_byte(cmd, (devAddress << 1) | I2C_MASTER_READ, I2C_MASTER_ACK_EN);
    i2c_master_read(cmd, data, len, I2C_MASTER_LAST_NACK);
    i2c_master_stop(cmd);
    esp_err_t err = i2c_master_cmd_begin(dev->def->i2cPort, cmd, (TickType_t)15);
    i2c_cmd_link_delete(cmd);

    xSemaphoreGive(dev->isBusFreeMutex);

#if defined CONFIG_I2CBUS_LOG_READWRITES

    if (!err) {
        char str[length * 5 + 1];

        for (size_t i = 0; i < length; i++) {
            sprintf(str + i * 5, "0x%s%X ", (data[i] < 0x10 ? "0" : ""), data[i]);
        }

        I2CBUS_LOG_RW("[port:%d, slave:0x%X] Read_ %d bytes from register 0x%X, data: %s", port, devAddr, length, regAddr, str);
    }

#endif
#if defined CONFIG_I2CBUS_LOG_ERRORS
#if defined CONFIG_I2CBUS_LOG_READWRITES
    else {
#else

    if (err) {
#endif
        I2CBUS_LOGE("[port:%d, slave:0x%X] Failed to read %d bytes from register 0x%X, error: 0x%X",
                    port, devAddr, length, regAddr, err);
    }

#endif

    if (err == ESP_OK) {
        return TRUE;
    } else {
        return false;
    }

}

bool i2cdevReadReg16(I2C_Dev *dev, uint8_t devAddress, uint16_t memAddress,
                     uint16_t len, uint8_t *data)
{
    if (xSemaphoreTake(dev->isBusFreeMutex, (TickType_t)5) == pdFALSE) {
        return false;
    }

    uint8_t memAddress8[2];
    memAddress8[0] = (uint8_t)((memAddress >> 8) & 0x00FF);
    memAddress8[1] = (uint8_t)(memAddress & 0x00FF);
    i2c_cmd_handle_t cmd = i2c_cmd_link_create();
    if (memAddress != I2C_NO_INTERNAL_ADDRESS) {
        i2c_master_start(cmd);
        i2c_master_write_byte(cmd, (devAddress << 1) | I2C_MASTER_WRITE, I2C_MASTER_ACK_EN);
        i2c_master_write(cmd, memAddress8, 2, I2C_MASTER_ACK_EN);
    }
    i2c_master_start(cmd);
    i2c_master_write_byte(cmd, (devAddress << 1) | I2C_MASTER_READ, I2C_MASTER_ACK_EN);
    i2c_master_read(cmd, data, len, I2C_MASTER_LAST_NACK);
    i2c_master_stop(cmd);
    esp_err_t err = i2c_master_cmd_begin(dev->def->i2cPort, cmd, (TickType_t)15);
    i2c_cmd_link_delete(cmd);

    xSemaphoreGive(dev->isBusFreeMutex);

#if defined CONFIG_I2CBUS_LOG_READWRITES

    if (!err) {
        char str[length * 5 + 1];

        for (size_t i = 0; i < length; i++) {
            sprintf(str + i * 5, "0x%s%X ", (data[i] < 0x10 ? "0" : ""), data[i]);
        }

        I2CBUS_LOG_RW("[port:%d, slave:0x%X] Read_ %d bytes from register 0x%X, data: %s", port, devAddr, length, regAddr, str);
    }

#endif
#if defined CONFIG_I2CBUS_LOG_ERRORS
#if defined CONFIG_I2CBUS_LOG_READWRITES
    else {
#else

    if (err) {
#endif
        I2CBUS_LOGE("[port:%d, slave:0x%X] Failed to read %d bytes from register 0x%X, error: 0x%X",
                    port, devAddr, length, regAddr, err);
    }

#endif

    if (err == ESP_OK) {
        return TRUE;
    } else {
        return false;
    }

}

bool i2cdevWriteByte(I2C_Dev *dev, uint8_t devAddress, uint8_t memAddress,
                     uint8_t data)
{
    return i2cdevWriteReg8(dev, devAddress, memAddress, 1, &data);
}

bool i2cdevWriteBit(I2C_Dev *dev, uint8_t devAddress, uint8_t memAddress,
                    uint8_t bitNum, uint8_t data)
{
    uint8_t byte;
    i2cdevReadByte(dev, devAddress, memAddress, &byte);
    byte = (data != 0) ? (byte | (1 << bitNum)) : (byte & ~(1 << bitNum));
    return i2cdevWriteByte(dev, devAddress, memAddress, byte);
}

bool i2cdevWriteBits(I2C_Dev *dev, uint8_t devAddress, uint8_t memAddress,
                     uint8_t bitStart, uint8_t length, uint8_t data)
{
    bool status;
    uint8_t byte;

    if ((status = i2cdevReadByte(dev, devAddress, memAddress, &byte)) == true) {
        uint8_t mask = ((1 << length) - 1) << (bitStart - length + 1);
        data <<= (bitStart - length + 1); // shift data into correct position
        data &= mask;                     // zero all non-important bits in data
        byte &= ~(mask);                  // zero all important bits in existing byte
        byte |= data;                     // combine data with existing byte
        status = i2cdevWriteByte(dev, devAddress, memAddress, byte);
    }

    return status;
}


bool i2cdevWriteReg8(I2C_Dev *dev, uint8_t devAddress, uint8_t memAddress,
                     uint16_t len, uint8_t *data)
{
    if (xSemaphoreTake(dev->isBusFreeMutex, (TickType_t)5) == pdFALSE) {
        return false;
    }

    i2c_cmd_handle_t cmd = i2c_cmd_link_create();
    i2c_master_start(cmd);
    i2c_master_write_byte(cmd, (devAddress << 1) | I2C_MASTER_WRITE, I2C_MASTER_ACK_EN);
    if (memAddress != I2CDEV_NO_MEM_ADDR) {
        i2c_master_write_byte(cmd, memAddress, I2C_MASTER_ACK_EN);
    }
    i2c_master_write(cmd, (uint8_t *)data, len, I2C_MASTER_ACK_EN);
    i2c_master_stop(cmd);
    esp_err_t err = i2c_master_cmd_begin(dev->def->i2cPort, cmd, (TickType_t)15);
    i2c_cmd_link_delete(cmd);

    xSemaphoreGive(dev->isBusFreeMutex);

#if defined CONFIG_I2CBUS_LOG_READWRITES

    if (!err) {
        char str[length * 5 + 1];

        for (size_t i = 0; i < length; i++) {
            sprintf(str + i * 5, "0x%s%X ", (data[i] < 0x10 ? "0" : ""), data[i]);
        }

        I2CBUS_LOG_RW("[port:%d, slave:0x%X] Write %d bytes to register 0x%X, data: %s",
                      port, devAddr, length, regAddr, str);
    }

#endif
#if defined CONFIG_I2CBUS_LOG_ERRORS
#if defined CONFIG_I2CBUS_LOG_READWRITES
    else {
#else

    if (err) {
#endif
        I2CBUS_LOGE("[port:%d, slave:0x%X] Failed to write %d bytes to__ register 0x%X, error: 0x%X",
                    port, devAddr, length, regAddr, err);
    }

#endif

    if (err == ESP_OK) {
        return TRUE;
    } else {
        return false;
    }
}

bool i2cdevWriteReg16(I2C_Dev *dev, uint8_t devAddress, uint16_t memAddress,
                      uint16_t len, uint8_t *data)
{
    if (xSemaphoreTake(dev->isBusFreeMutex, (TickType_t)5) == pdFALSE) {
        return false;
    }

    uint8_t memAddress8[2];
    memAddress8[0] = (uint8_t)((memAddress >> 8) & 0x00FF);
    memAddress8[1] = (uint8_t)(memAddress & 0x00FF);
    i2c_cmd_handle_t cmd = i2c_cmd_link_create();
    i2c_master_start(cmd);
    i2c_master_write_byte(cmd, (devAddress << 1) | I2C_MASTER_WRITE, I2C_MASTER_ACK_EN);
    if (memAddress != I2C_NO_INTERNAL_ADDRESS) {
        i2c_master_write(cmd, memAddress8, 2, I2C_MASTER_ACK_EN);
    }
    i2c_master_write(cmd, (uint8_t *)data, len, I2C_MASTER_ACK_EN);
    i2c_master_stop(cmd);
    esp_err_t err = i2c_master_cmd_begin(dev->def->i2cPort, cmd, (TickType_t)15);
    i2c_cmd_link_delete(cmd);

    xSemaphoreGive(dev->isBusFreeMutex);
#if defined CONFIG_I2CBUS_LOG_READWRITES

    if (!err) {
        char str[length * 5 + 1];

        for (size_t i = 0; i < length; i++) {
            sprintf(str + i * 5, "0x%s%X ", (data[i] < 0x10 ? "0" : ""), data[i]);
        }

        I2CBUS_LOG_RW("[port:%d, slave:0x%X] Write %d bytes to register 0x%X, data: %s",
                      port, devAddr, length, regAddr, str);
    }

#endif

#if defined CONFIG_I2CBUS_LOG_ERRORS
#if defined CONFIG_I2CBUS_LOG_READWRITES
    else {
#else

    if (err) {
#endif
        I2CBUS_LOGE("[port:%d, slave:0x%X] Failed to write %d bytes to__ register 0x%X, error: 0x%X",
                    port, devAddr, length, regAddr, err);
    }

#endif

    if (err == ESP_OK) {
        return TRUE;
    } else {
        return false;
    }
}
