Cosmo1233/CosFly/components/drivers/general/led/led_esp32.c

/**
*
 * ESP-Drone Firmware
 *
 * Copyright 2019-2020  Espressif Systems (Shanghai)
 * Copyright (C) 2011-2012 Bitcraze AB
 *
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
 * led.c - LED handing functions
 */
#include <stdbool.h>

/*FreeRtos includes*/
#include "freertos/FreeRTOS.h"
#include "freertos/task.h"
#include "driver/gpio.h"
#include "led.h"
#include "stm32_legacy.h"

#ifdef CONFIG_LED_VIA_PCA9534
#include "freertos/semphr.h"
#include "pca9534_port.h"

/*
 * CosFly V1: the LEDs are on PCA9534A (U3) port pins, not ESP32 GPIOs.
 * From the schematic:
 *   P0 VCOM_EXP_EN     load-switch enable for the breakout's VCOM, R12 pull-up
 *   P1 LED_GREEN_L     D2 green, common anode to 3V3 -> active low
 *   P2 LED_RED_L       D2 red,   common anode to 3V3 -> active low
 *   P3 LED_BLUE_L      D3 blue, cathode to GND        -> active high
 *   P6 LED_GREEN_RED_R power-LED select via U-switch S4: high = green, low = red
 *   P7 E_GPIO2         breakout header
 * The three Crazyflie LEDs map onto the left-hand LEDs. P0, P6 and P7 are
 * left as inputs, so their pull-ups keep VCOM on and the power LED green.
 */
#define EXP_PIN_GREEN_L  1
#define EXP_PIN_RED_L    2
#define EXP_PIN_BLUE_L   3

static unsigned int led_pin[] = {
    [LED_BLUE]  = EXP_PIN_BLUE_L,
    [LED_RED]   = EXP_PIN_RED_L,
    [LED_GREEN] = EXP_PIN_GREEN_L,
};
static int led_polarity[] = {
    [LED_BLUE]  = LED_POL_POS,
    [LED_RED]   = LED_POL_NEG,
    [LED_GREEN] = LED_POL_NEG,
};

static PCA9534_Handler_t expander;
static bool expanderReady = false;
// Local copy of the Output register. The library's PCA9534_WriteOne() reads
// the register back before every write (3 I2C transfers) and is not safe if
// two tasks change LEDs at once, so ledSet() updates this copy under a mutex
// and writes the whole byte in one transfer instead.
static uint8_t expanderOutputs;
static SemaphoreHandle_t expanderLock;
#else
static unsigned int led_pin[] = {
    [LED_BLUE] = LED_GPIO_BLUE,
    [LED_RED]   = LED_GPIO_RED,
    [LED_GREEN] = LED_GPIO_GREEN,
};
static int led_polarity[] = {
    [LED_BLUE] = LED_POL_BLUE,
    [LED_RED]   = LED_POL_RED,
    [LED_GREEN] = LED_POL_GREEN,
};
#endif

static bool isInit = false;

//Initialize the green led pin as output
void ledInit()
{
    int i;

    if (isInit) {
        return;
    }

#ifdef CONFIG_LED_VIA_PCA9534
    (void)i;
    expanderLock = xSemaphoreCreateMutex();
    pca9534PortLink(&expander, I2C0_DEV);

    // PCA9534_Init() also resets the chip: all pins inputs, outputs latched high.
    if (PCA9534_Init(&expander, PCA9534_DEVICE_PCA9534A, CONFIG_LED_PCA9534_ADDR_PINS) == PCA9534_OK) {
        // All levels high except blue, i.e. every LED off. Write the levels
        // before switching the pins to outputs so nothing flashes on.
        // Pins that stay inputs ignore the Output register.
        uint8_t outputs = (1 << EXP_PIN_GREEN_L) | (1 << EXP_PIN_RED_L) | (1 << EXP_PIN_BLUE_L);
        expanderOutputs = 0xFF & ~(1 << EXP_PIN_BLUE_L);
        PCA9534_Write(&expander, expanderOutputs);
        PCA9534_SetDir(&expander, outputs);     // 1 = output
        expanderReady = true;
    }
    isInit = true;
    return;
#endif

    for (i = 0; i < LED_NUM; i++) {
        gpio_config_t io_conf = {
            //bit mask of the pins that you want to set,e.g.GPIO18/19
            .pin_bit_mask = (1ULL << led_pin[i]),
            //disable pull-down mode
            .pull_down_en = 0,
            //disable pull-up mode
            .pull_up_en = 0,
            //set as output mode
            .mode = GPIO_MODE_OUTPUT,
        };
        //configure GPIO with the given settings
        gpio_config(&io_conf);
        ledSet(i, 0);
    }

    isInit = true;
}

bool ledTest(void)
{
    ledSet(LED_GREEN, 1);
    ledSet(LED_RED, 0);
    vTaskDelay(M2T(250));
    ledSet(LED_GREEN, 0);
    ledSet(LED_RED, 1);
    vTaskDelay(M2T(250));
    // LED test end
    ledClearAll();
    ledSet(LED_BLUE, 1);

    return isInit;
}

void ledClearAll(void)
{
    int i;

    for (i = 0; i < LED_NUM; i++) {
        //Turn off the LED:s
        ledSet(i, 0);
    }
}

void ledSetAll(void)
{
    int i;

    for (i = 0; i < LED_NUM; i++) {
        //Turn on the LED:s
        ledSet(i, 1);
    }
}
void ledSet(led_t led, bool value)
{
    if (led > LED_NUM || led == LED_NUM) {
        return;
    }

    if (led_polarity[led] == LED_POL_NEG) {
        value = !value;
    }

#ifdef CONFIG_LED_VIA_PCA9534
    // One I2C write. ledSet() is only called from task context (ledseq
    // timers, system task), never from an interrupt, so blocking is fine.
    if (!expanderReady) {
        return;
    }
    xSemaphoreTake(expanderLock, portMAX_DELAY);
    uint8_t next = value ? (expanderOutputs | (1 << led_pin[led]))
                         : (expanderOutputs & ~(1 << led_pin[led]));
    if (next != expanderOutputs) {
        expanderOutputs = next;
        PCA9534_Write(&expander, expanderOutputs);
    }
    xSemaphoreGive(expanderLock);
    return;
#endif

    if (value) {
        gpio_set_level(led_pin[led], 1);
    } else {
        gpio_set_level(led_pin[led], 0);
    }
}
