Cosmo1233/CosFly/(commit log)

2026-09-08 Remap pins for CosFly V1 board
    Apply the CosFly V1 schematic pin map over the LiteWing/ESP-Drone defaults.
    Values live in sdkconfig.defaults.esp32s3 (documented, survives a fresh
    checkout) and in the live sdkconfig.
    Motors -> 2/41/7/8, SPI (BMI270 IMU) -> 38/37/39/40, sensor I2C0 (BMP280,
    BMM150) -> 33/34, battery ADC -> 3.
    Three LiteWing peripherals collided with the new map and are all initialised
    at boot, so they had to move rather than be left alone:
    - I2C1 "deck bus" (EEPROM + PCA expander) sat on 40/41, now SPI CS0 and
    MOTOR02. Parked on unused 14/15 until that bus is mapped; the EEPROM probe
    fails harmlessly and configblock falls back to defaults.
    - LED GREEN/RED sat on 7/8, no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
2026-09-08 Route config-block EEPROM and PCA expander through I2C0 on CosFly V1
    CosFly V1 has a single internal I2C bus (schematic: INT_SDA/INT_SCL,
    GPIO33/34) shared by the barometer, magnetometer, config-block EEPROM,
    and the PCA GPIO expander -- unlike LiteWing, which puts the EEPROM
    and expander on a separate "deck bus" (I2C1, a second ESP32-S3 I2C
    hardware peripheral). Repointing both to I2C1_DEV would mean two
    peripherals driving the same physical pins, so configblockeeprom.c
    and pca9555.c/pca95x4.c now use I2C0_DEV instead.
    I2C1's GPIO14/15 placeholder pins are now just unused -- nothing on
    CosFly V1 references I2C1_DEV except the dormant VL53L0/L1 flow-deck
    drivers, which have no hardware to d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
2026-09-08 Add Bosch BMI270 SensorAPI as an ESP-IDF component
    Vendor drop of the official Bosch BMI270_SensorAPI v2.86.1 (BSD-3-Clause),
    sources unmodified, so the next commit -- the ESP-IDF SPI glue -- stays a
    readable diff of our own code rather than being buried in vendor churn.
    Placed under components/drivers/spi_devices/bmi270 alongside pmw3901; that
    directory is on EXTRA_COMPONENT_DIRS, so a CMakeLists.txt is all it takes
    for ESP-IDF to pick it up as a component.
    Included: bmi2.c/bmi270.c plus bmi2.h, bmi270.h, bmi2_defs.h (headers under
    include/). bmi270.c carries the ~8KB config blob the chip requires at init.
    Deliberately not included:
    - common.c/h -- Bosch's COINES shuttle-board glue. The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
2026-09-29 Replace LiteWing hardware files with CosFly component datasheets
    Drop the LiteWing V2.5C / V2.6C KiCad projects, positioning-module PDF,
    README images, and the datasheets for parts CosFly doesn't use (MPU6050,
    MS5611, ESP32-S3-WROOM-1).
    Add datasheets for the CosFly V1 ICs: ESP32 SFN8, BMI270, BMM150, BMP280,
    BQ24075, chip antenna, PCA9534, VL53L3CX, VL53L5CX.
    [LieWingV2.6.C.kicad_pcb, LieWingV2.6.C.kicad_sch, LiteWingV2.5C.kicad_pcb, LiteWingV2.5C.kicad_sch, bom.csv, designators.csv, positions.csv]
2026-09-29 Add BMI270 INT1/INT2 pins for CosFly V1
    INT1 -> GPIO36 (reuses the existing MPU_PIN_INT option), INT2 -> GPIO35
    via a new IMU_PIN_INT2 Kconfig entry so the value survives menuconfig.
    Per the BMI270 datasheet (sec 4.9.2, reg 0x58 INT_MAP_DATA) neither pin
    is fixed to accel or gyro; all sources are software-mappable to either.
2026-09-29 Add BMP280 and VL53L3 driver sources, lockfile, ignore bchk/
    The driver drops have no CMakeLists.txt yet, so ESP-IDF does not build
    them; they still need a component file and ESP-IDF I2C port glue
    (vl53l3 ships with STM32 HAL platform code).
2026-09-30 Fix motor 2 and battery ADC pins from the CosFly V1 schematic
    The schematic netlist puts Motor R-Up on chip pin 48 (MTMS = GPIO42),
    not GPIO41 (pin 47, E_TX2), and ADC_BAT on pin 9 (GPIO4), not GPIO3.
    The ADC driver also hard-coded ADC1 channel 1, which on ESP32-S3 is
    GPIO2 (Motor L-Up), ignoring CONFIG_ADC1_PIN entirely. Derive the
    channel from the pin instead (ADC1 channel n = GPIO n+1 on S2/S3).
    Battery divider is 200k/100k on CosFly, so VBAT = 3 x Vadc (was 2).
    [adc_esp32.c, pm_esplane.c]
2026-09-30 Add ESP-IDF ports for BMI270, BMP280 and BMM150 drivers
    Each vendor driver stays unmodified and gets a small port file that
    fills in its function-pointer interface:
    - bmi270_port.c: SPI2 bus on CONFIG_SPI_PIN_* with hardware CS,
    8 MHz, no DMA (Bosch API bursts are capped at 32 bytes).
    - bmp280_port.c / bmm150_port.c: LibDriver I2C callbacks on top of
    the project's i2cdev layer (shares the bus mutex). SPI callbacks
    are stubs because LibDriver init rejects NULL pointers.
    Adds the LibDriver BMM150 sources and CMakeLists for BMP280/BMM150,
    which previously were not built at all.
2026-09-30 Add CosFly V1 sensor implementation (BMI270 + BMP280 + BMM150)
    New sensors_bmi270_bmp280_bmm150.c replaces the MPU6050 set, whose
    drivers were removed. Selected through a new "CF01" platform entry,
    now the default device type.
    - IMU loop paced by a 1 kHz esp_timer: the stabilizer and filters
    assume 1 kHz and the BMI270 only offers 25 Hz x 2^n rates, so it
    runs at 1600 Hz and the latest sample is read each tick.
    - BMI270 INT1 = data-ready, active-low open-drain (4.7k pull-ups on
    the board); pulses counted in log imu_drdy.count as a wiring check.
    - Baro and mag read in a separate 50 Hz BAROMAG task (alternating,
    ~25 Hz each) so shared-I2C traffic never delays the IMU loop.
    - Board ori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
    [config.h, sensors.c, sensors_bmi270_bmp280_bmm150.c]
2026-09-30 Drive CosFly status LEDs through the PCA9534A expander
    New pca9534 component: minimal driver for the PCA9534/PCA9534A on top
    of i2cdev, with a cached Output register so an LED change is one I2C
    write. The vendor PCA9534_platform.c was not used: it installs its own
    I2C driver on I2C_NUM_0 with SDA on GPIO2, which on CosFly is Motor
    L-Up and would clash with the existing I2C0 owner.
    New Kconfig LED_VIA_PCA9534 (+ LED_PCA9534_ADDR, 0x38 for PCA9534A with
    A2..A0 = GND). When set, led_esp32.c maps the Crazyflie LEDs onto the
    left-hand LEDs per the schematic: green P1 and red P2 (common-anode,
    active low), blue P3 (active high). P0 VCOM_EXP_EN, P6 power-LED select
    and P7 E_GPIO2 stay inputs so th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
2026-09-30 Use the Mahda PCA9534 library for the LED expander
    Replace the hand-written pca9534.c with the Mahda PCA9534/PCA9534A
    driver (unmodified) plus a CosFly port file, matching how the other
    vendor drivers are integrated. The library's sample
    PCA9534_platform.c is still not used: it installs its own I2C driver
    on GPIO1/GPIO2, and GPIO2 is Motor L-Up. pca9534_port.c routes
    Send/Receive through i2cdev on I2C0 instead.
    led_esp32.c keeps a mutex-protected copy of the Output register and
    writes it with PCA9534_Write(), since the library's WriteOne() does a
    read-modify-write that races between tasks.
    Kconfig LED_PCA9534_ADDR (raw address) becomes LED_PCA9534_ADDR_PINS
    (A2..A0 strap value), which is w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
    [PCA9534.c, PCA9534.h, i2cdev_esp32.c, led_esp32.c, pca9534_port.c, pca9534_port.h]
2026-09-30 Remove LiteWing sensor drivers, add CosFly V1 schematics
    - Drop the MPU6050, HMC5883L and MS5611 drivers: CosFly uses the
    BMI270/BMP280/BMM150 instead, and nothing references them any more.
    - Add the flight controller schematics (main, power management,
    sensors) under Documents/Schematics.
    - Rename the VL53L5CX datasheet to vl53l5cx.pdf.
2026-09-30 Remove LiteWing leftovers and add a CosFly README
    - Drop LiteWing-Arduino/ (LiteWing's separate Arduino firmware) and
    "LiteWing Firmware binary files/" (prebuilt LiteWing images); neither
    is part of the ESP-IDF build or useful on CosFly hardware.
    - Replace LiteWing's README with a CosFly one: hardware summary, build
    steps, layout, and credits to Crazyflie, ESP-Drone, LiteWing and the
    vendor driver authors. LICENSE (GPL-3.0) is kept as required.
2026-10-01 Add BMI270 no-motion detection on INT2
    The BMI270's built-in no-motion feature (datasheet 4.8.3) now reports
    when the drone is at rest: slope below ~15 mg on all axes for 1 s.
    The result is logged as imu_motion.still (1 = still).
    New Kconfig IMU_INT2_NO_MOTION (default y):
    - y: no-motion is mapped to INT2 (active-low open-drain, R29 pull-up)
    and the ESP32 reads GPIO35's level every 40 ms.
    - n: GPIO35 is never touched, so a future board can reuse it; the
    firmware polls INT_STATUS_0 over SPI from the sensors task instead.
    Both paths build clean; neither has run on hardware yet. Not yet used
    by any flight logic (candidates: gating gyro calibration, landing
    detection).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
2026-10-09 Remap motors to the Crazyflie X layout and move I2C1 to the breakout
    Motor pins now follow the Crazyflie layout the mixer expects (M1
    front-right ... M4 front-left), checked on the board with the motor
    test. Add a PID_CRAZYFLIE_DEFAULTS option (on by default) to start
    tuning from the Crazyflie 2.x gains. I2C1, the deck bus, now uses the
    breakout header's E_SDA/E_SCL (GPIO10/13).
2026-10-09 Add a standalone board bring-up test
    tools/board_test is a separate ESP-IDF app that checks each part of the
    CosFly V1 board and prints PASS/WARN/FAIL with probing hints: I2C bus and
    chips, BMI270 over SPI with its interrupts, EEPROM, LEDs, battery ADC,
    buttons, Wi-Fi/antenna, motor drive pins and the breakout headers. Keys
    in its live readout run the motor, full-throttle, battery-only and
    endurance tests, saving battery-only results to flash.
2026-10-09 Replace the schematics with the corrected V1 PDF
2026-10-15 Add the Altium V1 flight controller project under hardware/
    Schematics, PCB, libraries, OutJob, STEP model and the fab outputs
    (gerbers, BOMs, pick-and-place) for the V1 board. Altium's local
    History backups, previews and ECO logs are ignored, and .gitattributes
    keeps the CAD and fab files byte-exact by skipping line-ending
    conversion.
