Cosmo1233/CosFly/(notices)

Notices in the files:
components/core/crazyflie/utils/src/configblockeeprom.c:
This program is free software: you can redistribute it and/or modify
it under the terms of the GNU General Public License as published by
the Free Software Foundation, in version 3.
